JeanPatrique/ProjetButESE/emetteur/misc/imageCamera.jpg

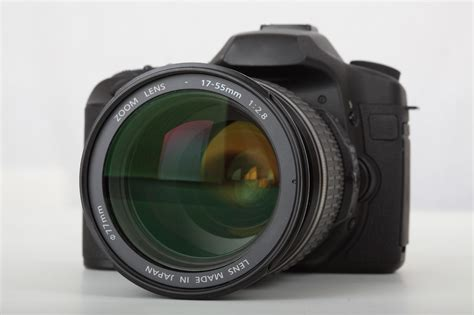
emetteur/misc/imageCamera.jpg
