JeanPatrique/ProjetButESE/emetteur/misc/imageCableVGA.jpg

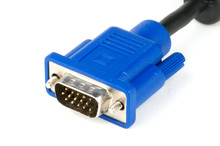
emetteur/misc/imageCableVGA.jpg
