JeanPatrique/ProjetButESE/recepteur/sub_sheets/res/chronogramme_memoryIC_ISSI.png

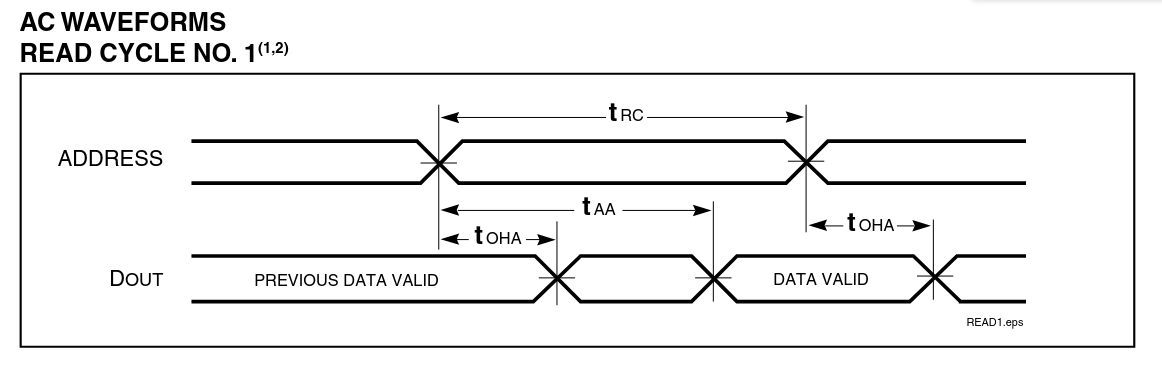
recepteur/sub_sheets/res/chronogramme_memoryIC_ISSI.png
