JeanPatrique/ProjetButESE/emetteur/symbolesEtEmpreintes/AND_1b/AND_gate_NL17SZ08DBVT1G.stp

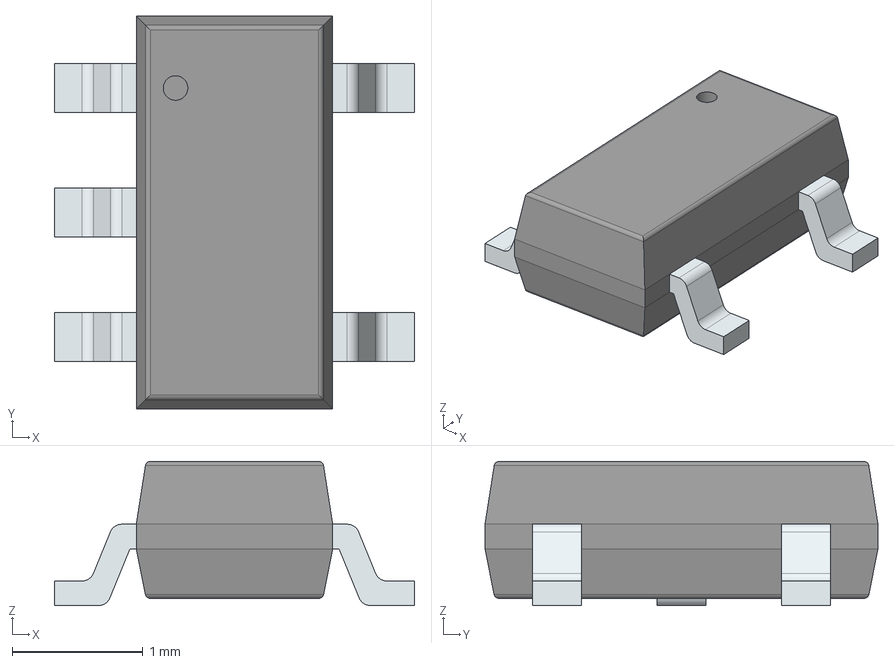
[picture p4: CAD file, 2026-03-14]
emetteur/symbolesEtEmpreintes/AND_1b/AND_gate_NL17SZ08DBVT1G.stp
2.75 x 3.00 x 1.10 mm
PinsArrayL
PinsArrayR
