JeanPatrique/ProjetButESE/emetteur/symbolesEtEmpreintes/C_100n/C_100n_C1608X7R1H104K080AA.stp

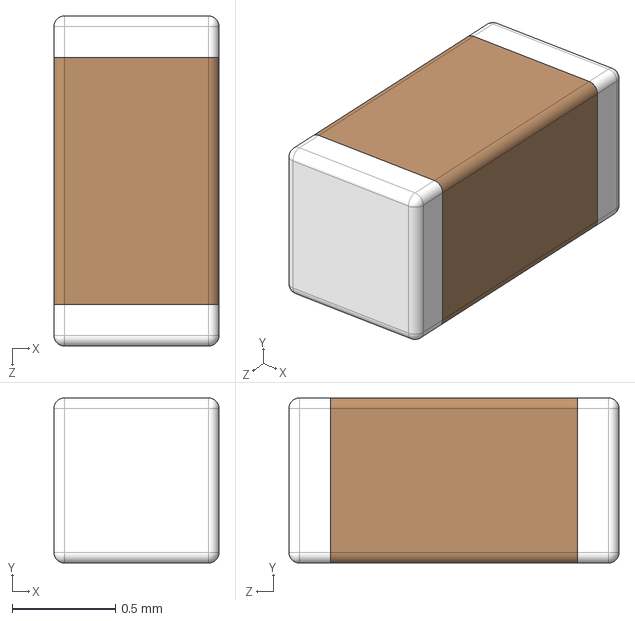
[picture p5: CAD file, 2026-03-14]
emetteur/symbolesEtEmpreintes/C_100n/C_100n_C1608X7R1H104K080AA.stp
0.8 x 0.8 x 1.60 mm
