JeanPatrique/ProjetButESE/emetteur/symbolesEtEmpreintes/C_1u/C_1u_C1005X5R1E105K050BC.stp

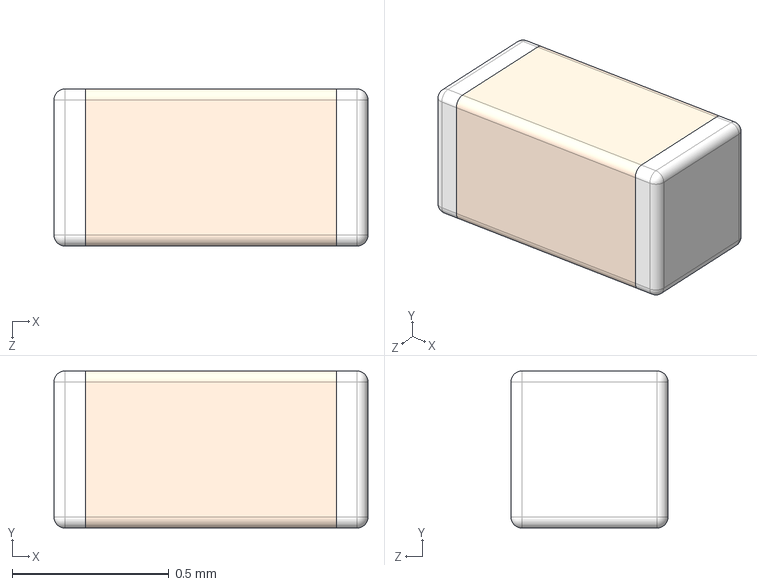
[picture p6: CAD file, 2026-03-14]
emetteur/symbolesEtEmpreintes/C_1u/C_1u_C1005X5R1E105K050BC.stp
1.00 x 0.5 x 0.5 mm
