JeanPatrique/ProjetButESE/emetteur/symbolesEtEmpreintes/C_2u2/C_2u2_C2012X7R1H225K125AE.stp

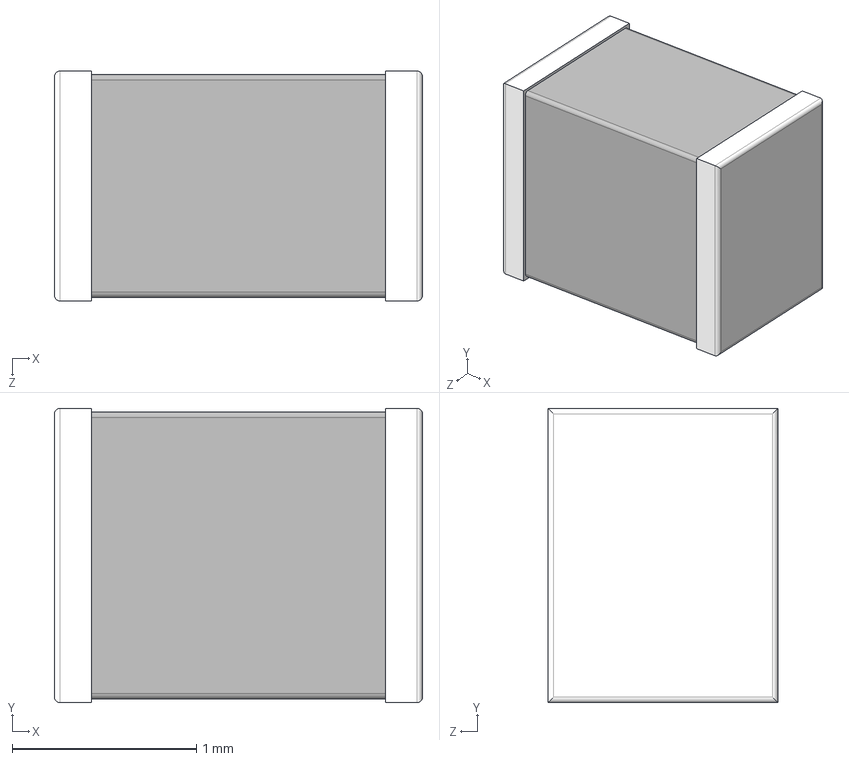
[picture p7: CAD file, 2026-03-14]
emetteur/symbolesEtEmpreintes/C_2u2/C_2u2_C2012X7R1H225K125AE.stp
2.00 x 1.60 x 1.25 mm
