JeanPatrique/ProjetButESE/emetteur/symbolesEtEmpreintes/C_47u/C_47u_C3216X5R1E476M160AC.stp

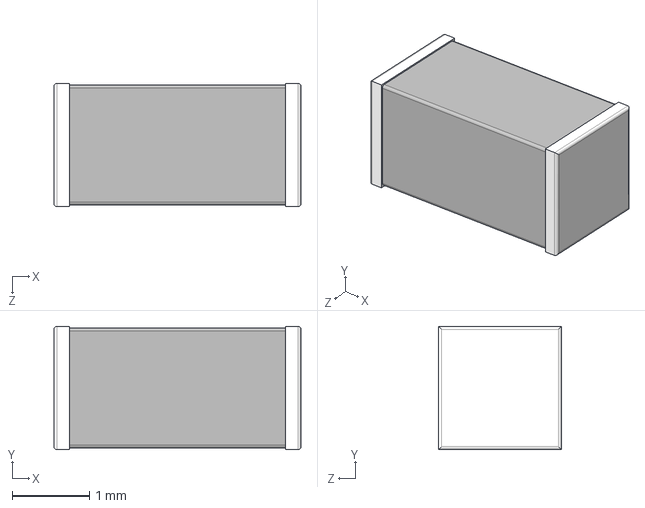
[picture p8: CAD file, 2026-03-14]
emetteur/symbolesEtEmpreintes/C_47u/C_47u_C3216X5R1E476M160AC.stp
3.20 x 1.60 x 1.60 mm
