JeanPatrique/ProjetButESE/emetteur/symbolesEtEmpreintes/counter_8b/counter_8b_SN74HCS594DYYR.stp

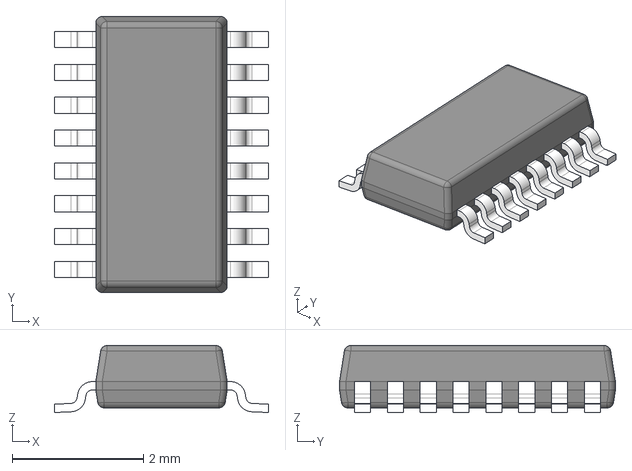
[picture p9: CAD file, 2026-03-14]
emetteur/symbolesEtEmpreintes/counter_8b/counter_8b_SN74HCS594DYYR.stp
3.26 x 4.20 x 1.02 mm
BODY-TSSOP
LEAD-TSSOP x 16
