JeanPatrique/ProjetButESE/emetteur/symbolesEtEmpreintes/D_latches_x8/D_latches_x8_74LVC373APW,118.stp

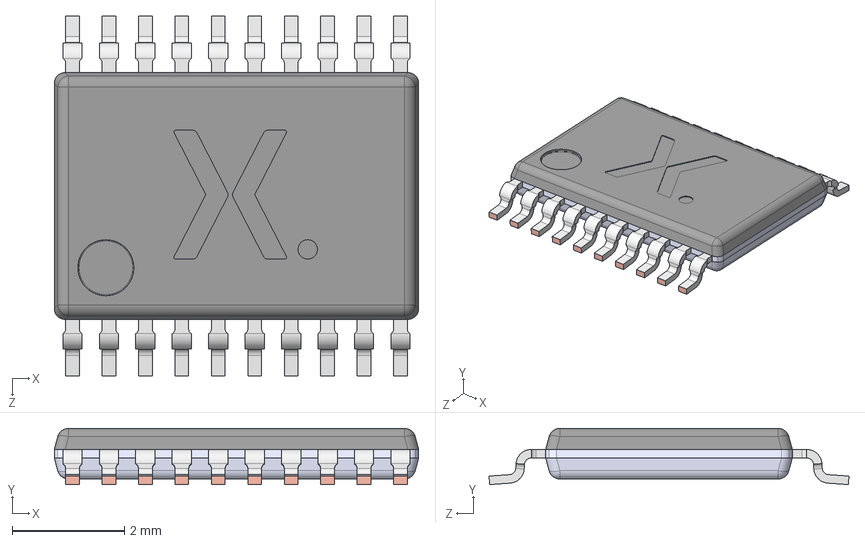
[picture p10: CAD file, 2026-03-14]
emetteur/symbolesEtEmpreintes/D_latches_x8/D_latches_x8_74LVC373APW,118.stp
6.50 x 1.00 x 6.42 mm
SOT360-1 Lower Mold body
SOT360-1 Lead
SOT360-1 Upper Mold body
