JeanPatrique/ProjetButESE/emetteur/symbolesEtEmpreintes/Diode_TVS/DF2S23P2FU,H3F.stp

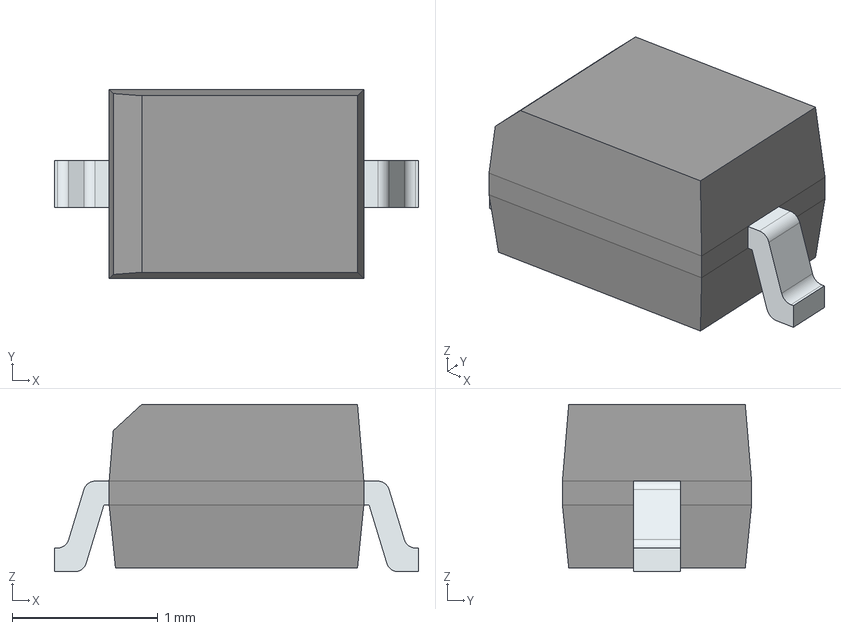
[picture p11: CAD file, 2026-03-14]
emetteur/symbolesEtEmpreintes/Diode_TVS/DF2S23P2FU,H3F.stp
2.50 x 1.30 x 1.15 mm
FilletPinL
FilletPinR
