JeanPatrique/ProjetButESE/emetteur/symbolesEtEmpreintes/JK_latch/JK_latch_SN74LVC112ADR.stp

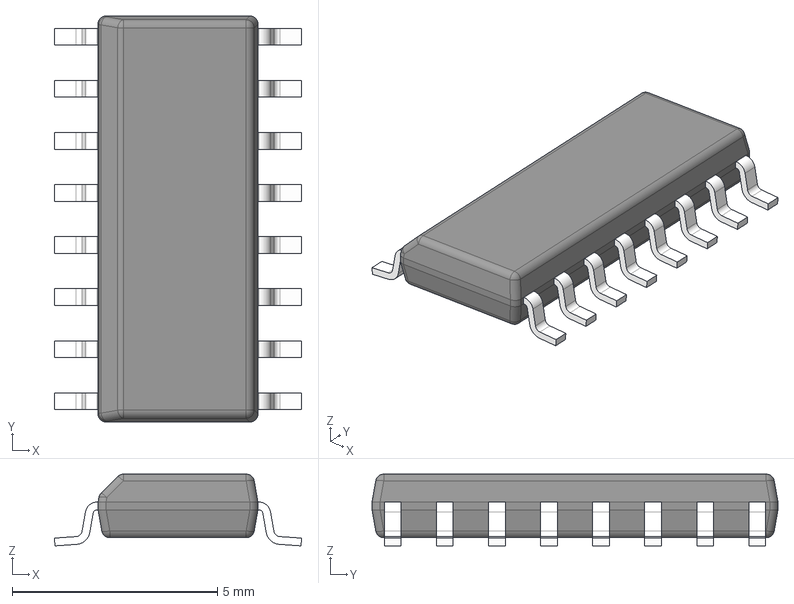
[picture p12: CAD file, 2026-03-14]
emetteur/symbolesEtEmpreintes/JK_latch/JK_latch_SN74LVC112ADR.stp
6.03 x 9.90 x 1.75 mm
BODY-SO
LEAD-SO x 16
PIN1-ID
