JeanPatrique/ProjetButESE/emetteur/symbolesEtEmpreintes/led_verte/LED_VERTE_HLMP-Y502-F0000.stp

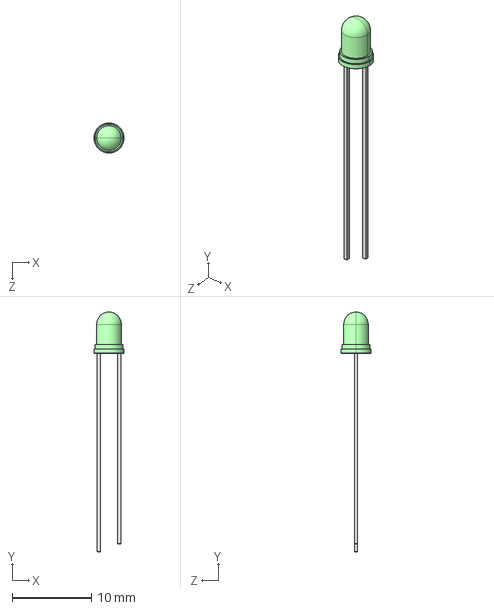
[picture p13: CAD file, 2026-03-14]
emetteur/symbolesEtEmpreintes/led_verte/LED_VERTE_HLMP-Y502-F0000.stp
3.80 x 30.2 x 3.80 mm
