JeanPatrique/ProjetButESE/emetteur/symbolesEtEmpreintes/mcu/MCU_STM32H523CET6.stp

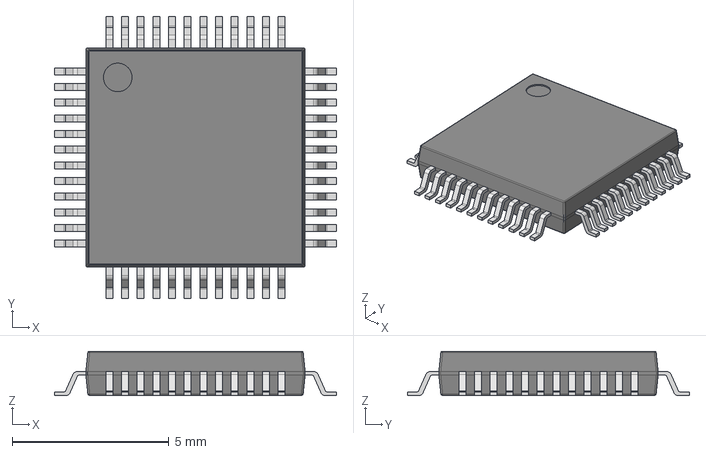
[picture p14: CAD file, 2026-03-14]
emetteur/symbolesEtEmpreintes/mcu/MCU_STM32H523CET6.stp
9.00 x 9.00 x 1.41 mm
