JeanPatrique/ProjetButESE/emetteur/symbolesEtEmpreintes/NAND_1b/NAND_gate_NC7SZ00M5X.stp

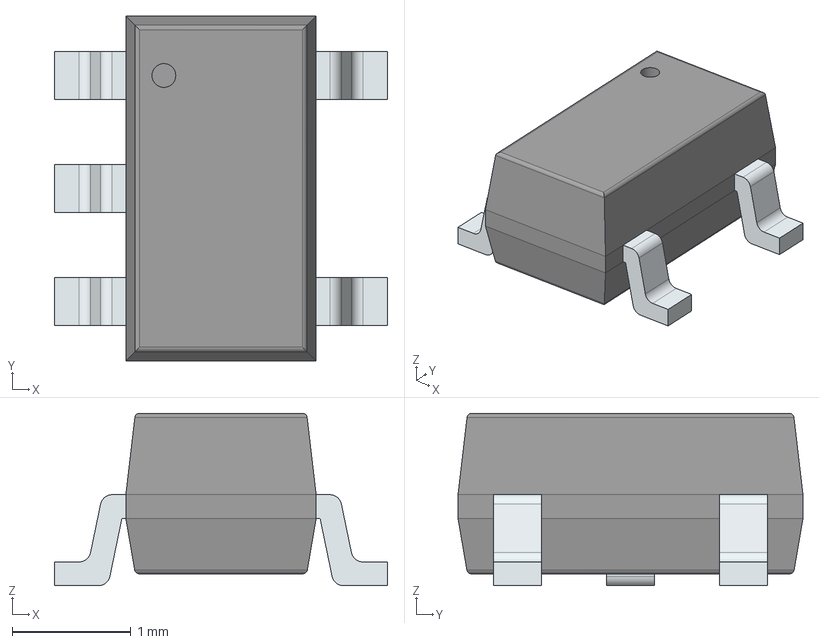
[picture p15: CAD file, 2026-03-14]
emetteur/symbolesEtEmpreintes/NAND_1b/NAND_gate_NC7SZ00M5X.stp
2.80 x 2.90 x 1.45 mm
PinsArrayL
PinsArrayR
