JeanPatrique/ProjetButESE/emetteur/symbolesEtEmpreintes/OR_1b/OR_gate_NL17SZ32XV5T2G.stp

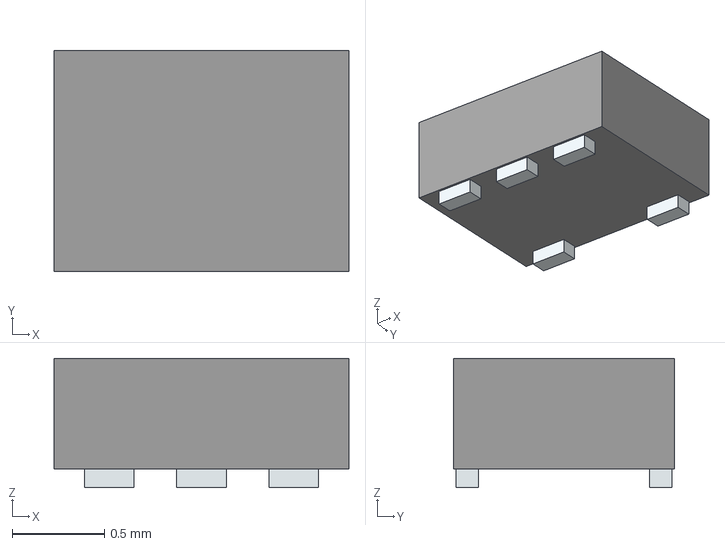
[picture p16: CAD file, 2026-03-14]
emetteur/symbolesEtEmpreintes/OR_1b/OR_gate_NL17SZ32XV5T2G.stp
1.60 x 1.20 x 0.7 mm
Pins
