JeanPatrique/ProjetButESE/emetteur/symbolesEtEmpreintes/plexeur_1b/plexeur_1b_74LVC1G3157GW,125.stp

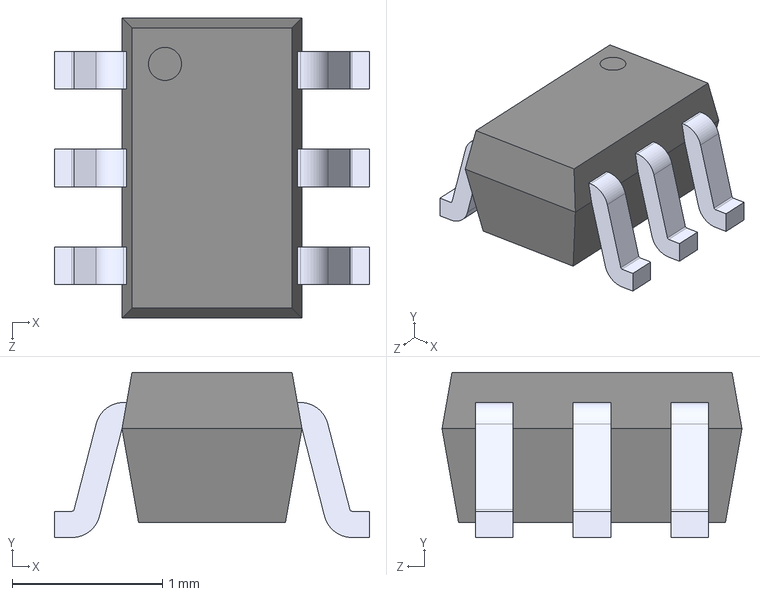
[picture p17: CAD file, 2026-03-14]
emetteur/symbolesEtEmpreintes/plexeur_1b/plexeur_1b_74LVC1G3157GW,125.stp
2.10 x 1.10 x 2.00 mm
