JeanPatrique/ProjetButESE/emetteur/symbolesEtEmpreintes/powerJackConnector/PowerJackCon_PJ-114AH-SMT-TR.stp

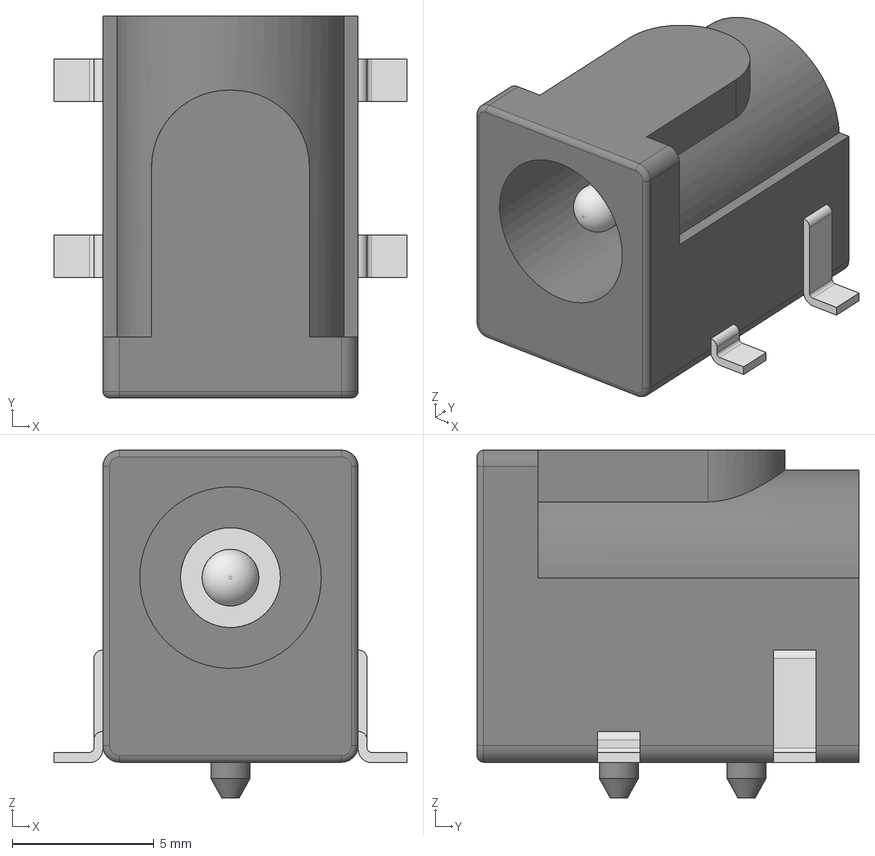
[picture p18: CAD file, 2026-03-14]
emetteur/symbolesEtEmpreintes/powerJackConnector/PowerJackCon_PJ-114AH-SMT-TR.stp
12.4 x 13.5 x 12.3 mm
