JeanPatrique/ProjetButESE/emetteur/symbolesEtEmpreintes/regulateur_3v3_1A/regulateur_3V3_1A_TLV76133DCYR.stp

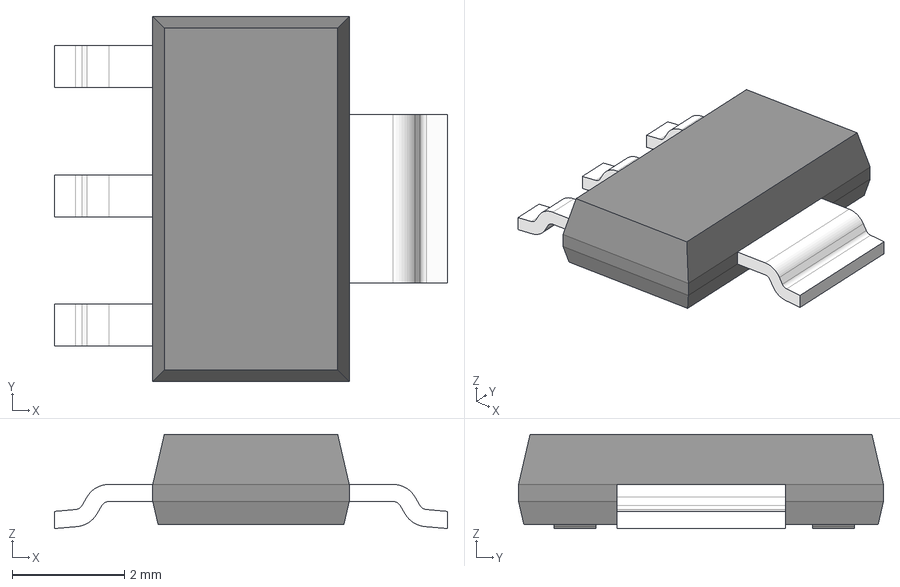
[picture p19: CAD file, 2026-03-14]
emetteur/symbolesEtEmpreintes/regulateur_3v3_1A/regulateur_3V3_1A_TLV76133DCYR.stp
7.00 x 6.50 x 1.68 mm
BODY-SOT
LEAD-SOT x 3
LEAD-SOT-WIDE
PIN1-ID
