JeanPatrique/ProjetButESE/emetteur/symbolesEtEmpreintes/SRAM/SRAM_IS61WV5128FBLL-10TLI.stp

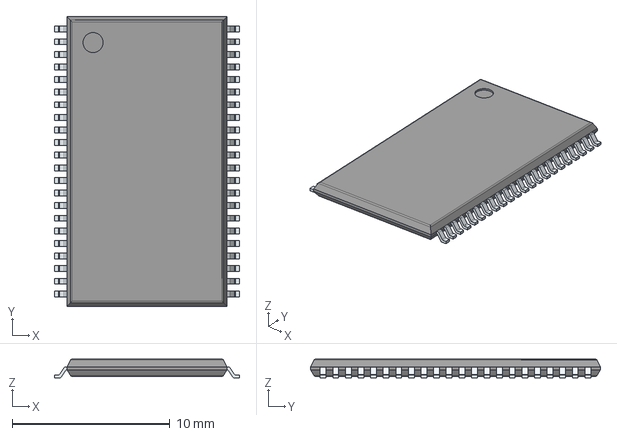
[picture p20: CAD file, 2026-03-14]
emetteur/symbolesEtEmpreintes/SRAM/SRAM_IS61WV5128FBLL-10TLI.stp
11.8 x 18.4 x 1.20 mm
PinsArrayLR
