JeanPatrique/ProjetButESE/emetteur/symbolesEtEmpreintes/switch_3/swicth_3_DS01C-254-L-03BE.stp

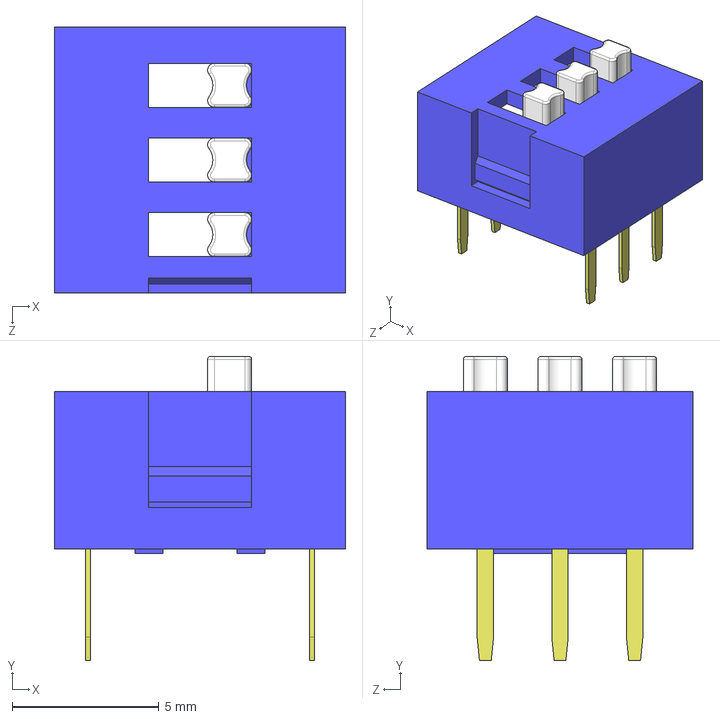
[picture p21: CAD file, 2026-03-14]
emetteur/symbolesEtEmpreintes/switch_3/swicth_3_DS01C-254-L-03BE.stp
9.90 x 10.4 x 9.04 mm
