JeanPatrique/ProjetButESE/emetteur/symbolesEtEmpreintes/led_verte/LED_ROUGE_HLMP-Y301-F0000.stp

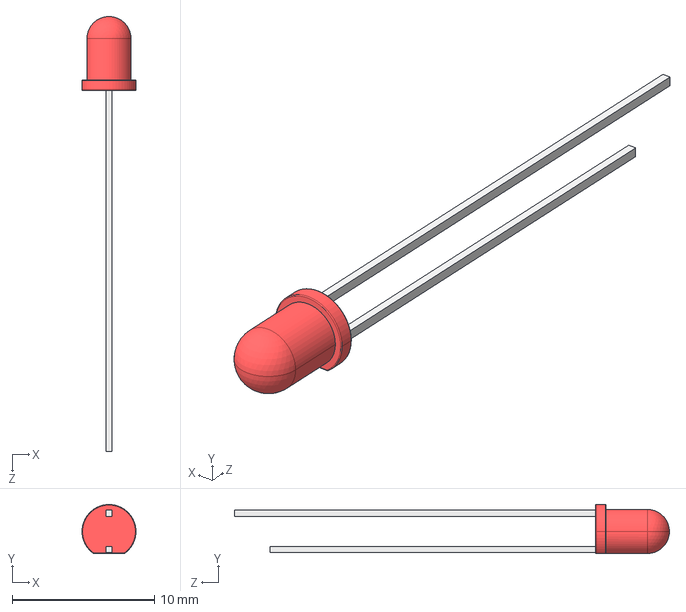
[picture p22: CAD file, 2026-03-14]
emetteur/symbolesEtEmpreintes/led_verte/LED_ROUGE_HLMP-Y301-F0000.stp
3.80 x 3.45 x 30.6 mm
