JeanPatrique/ProjetButESE/emetteur/schemasEmetteur_rev1.pdf

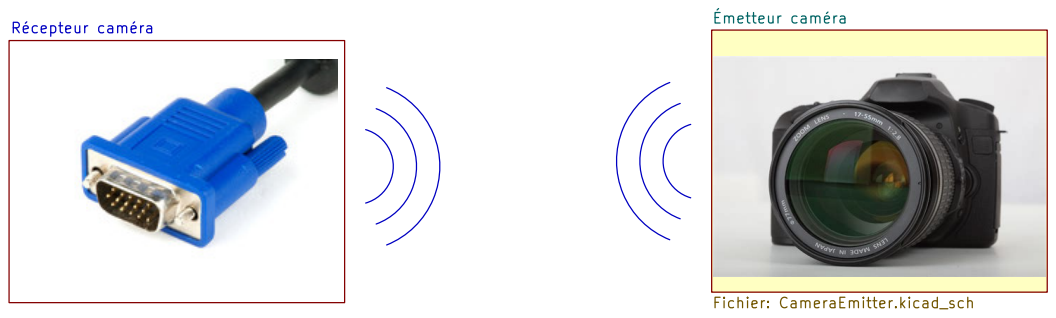
[picture p23: page 1]

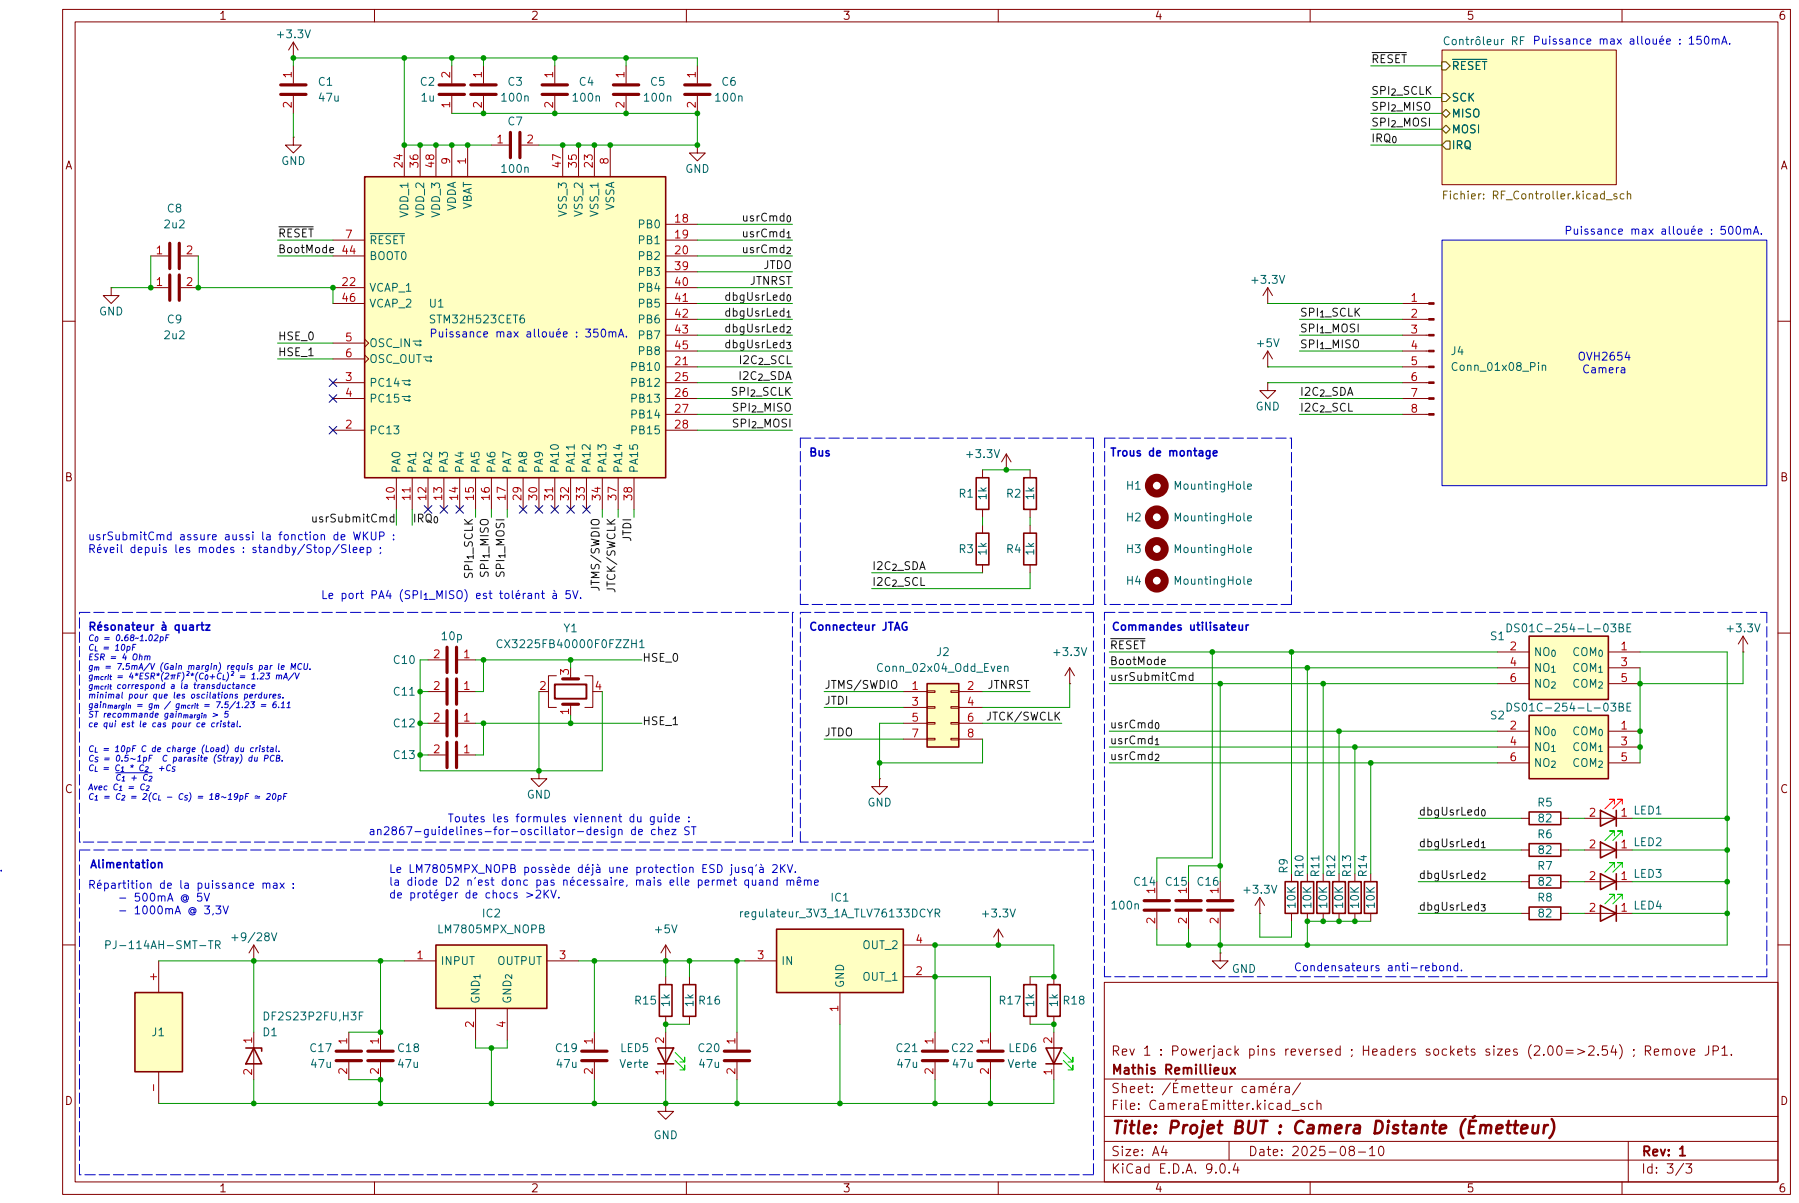
[picture p24: page 2]

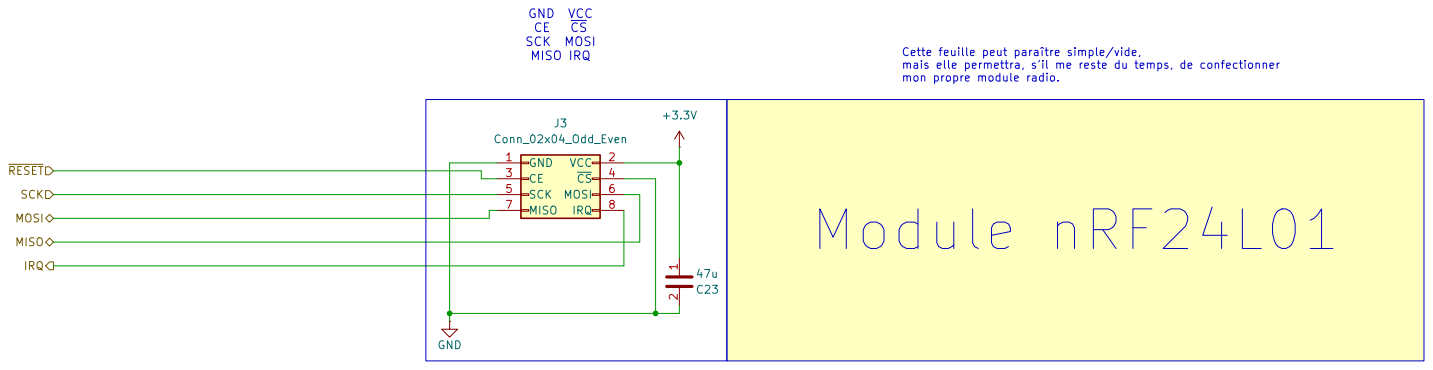
[picture p25: page 3]
