JeanPatrique/ProjetButESE/emetteur/schemasEmetteur_rev0.pdf

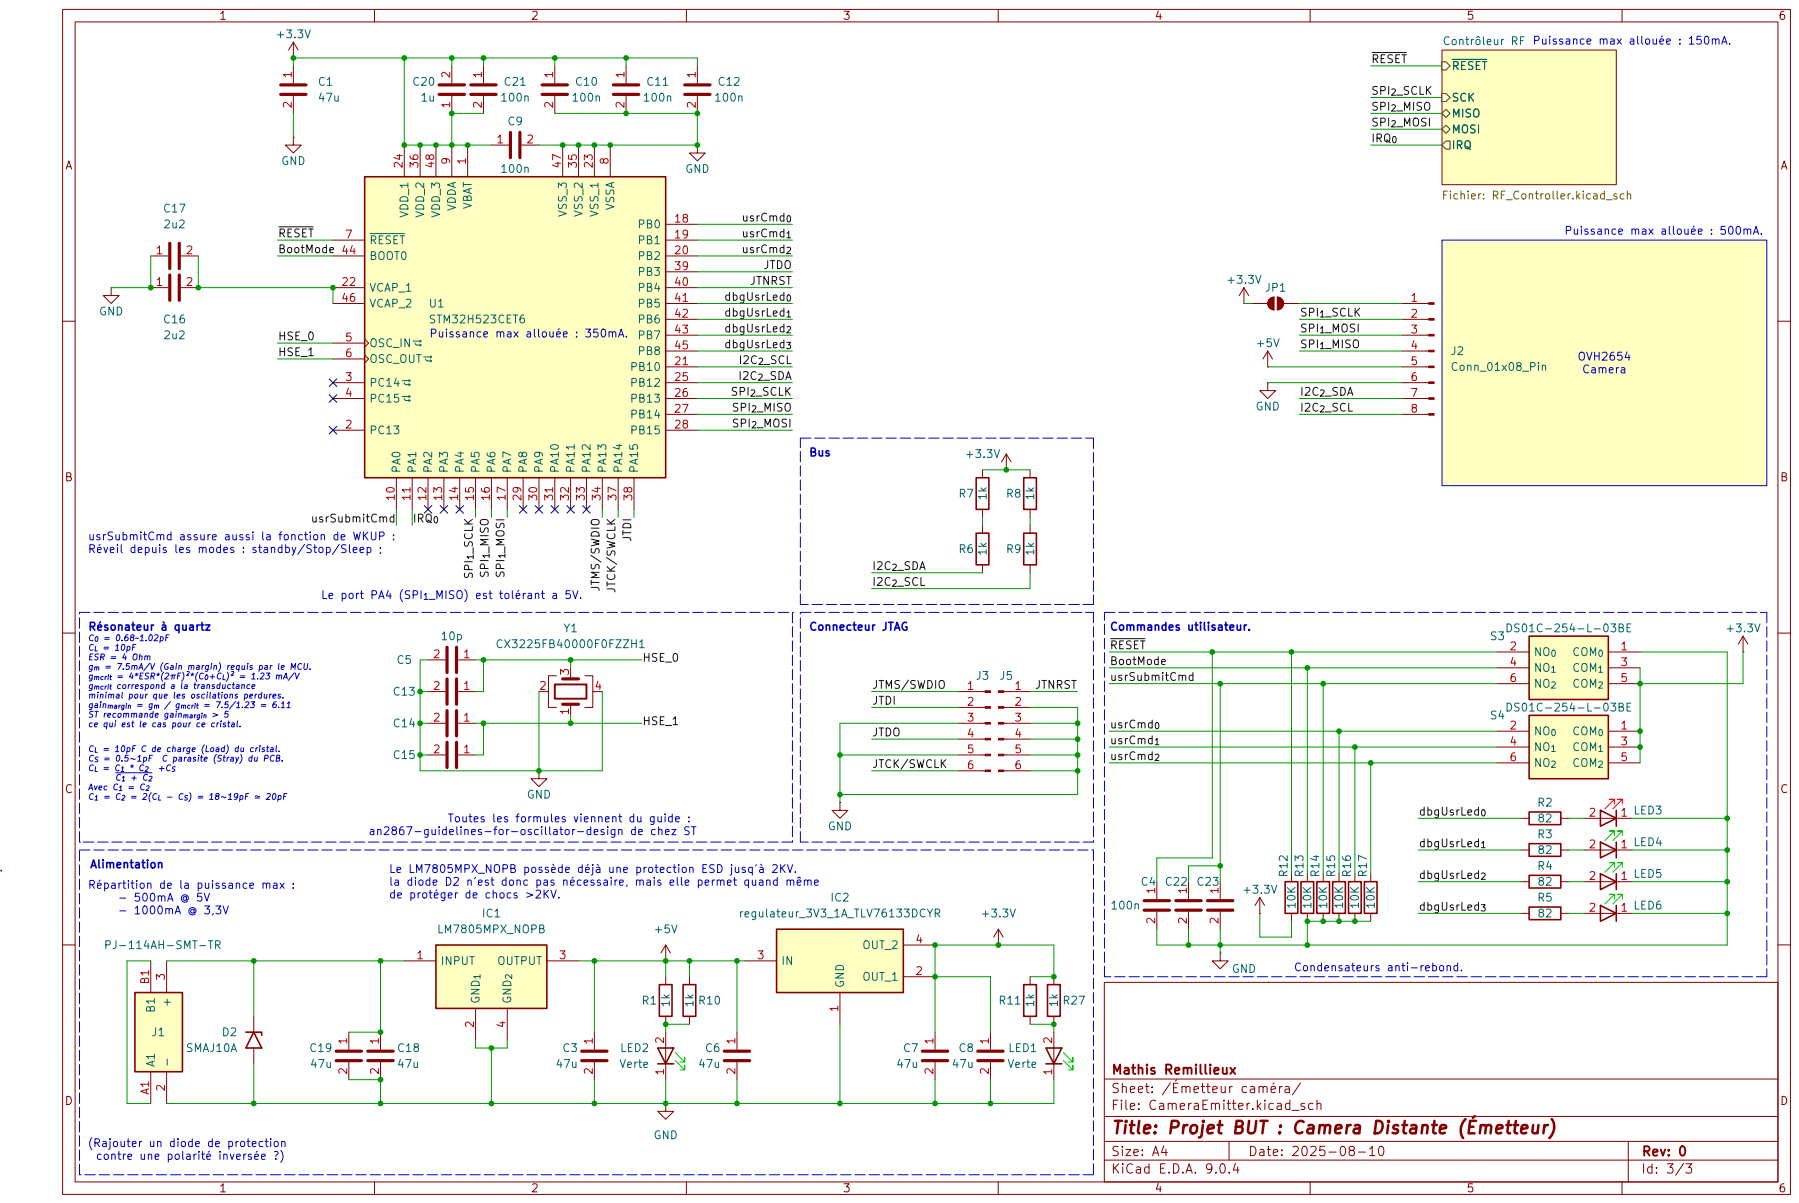
[picture p26: page 2]

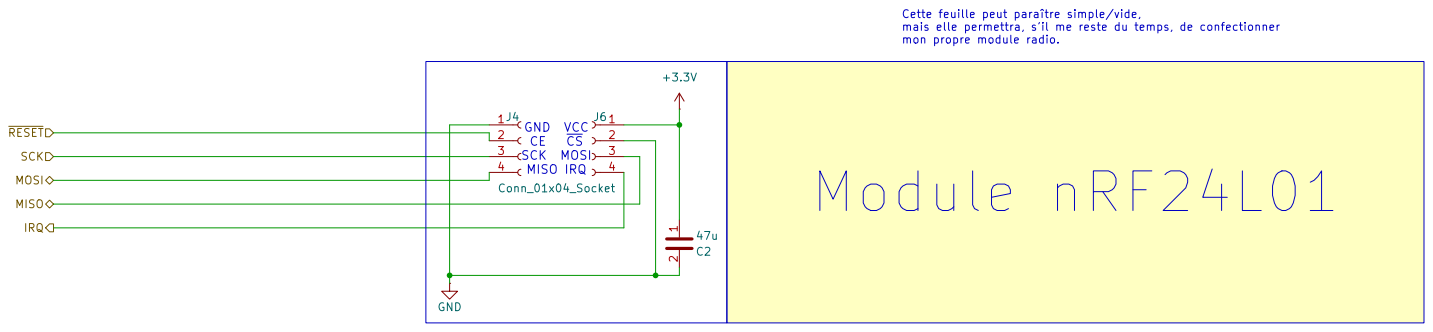
[picture p27: page 3]
