JeanPatrique/ProjetButESE/Cartes de tests et prototypes/carte de test du convertisseur numerique vers analogique/testCNA.kicad_pcb

## KiCad design Cartes de tests et prototypes/carte de test du convertisseur numerique vers analogique/testCNA.kicad_pcb (2026-03-14)

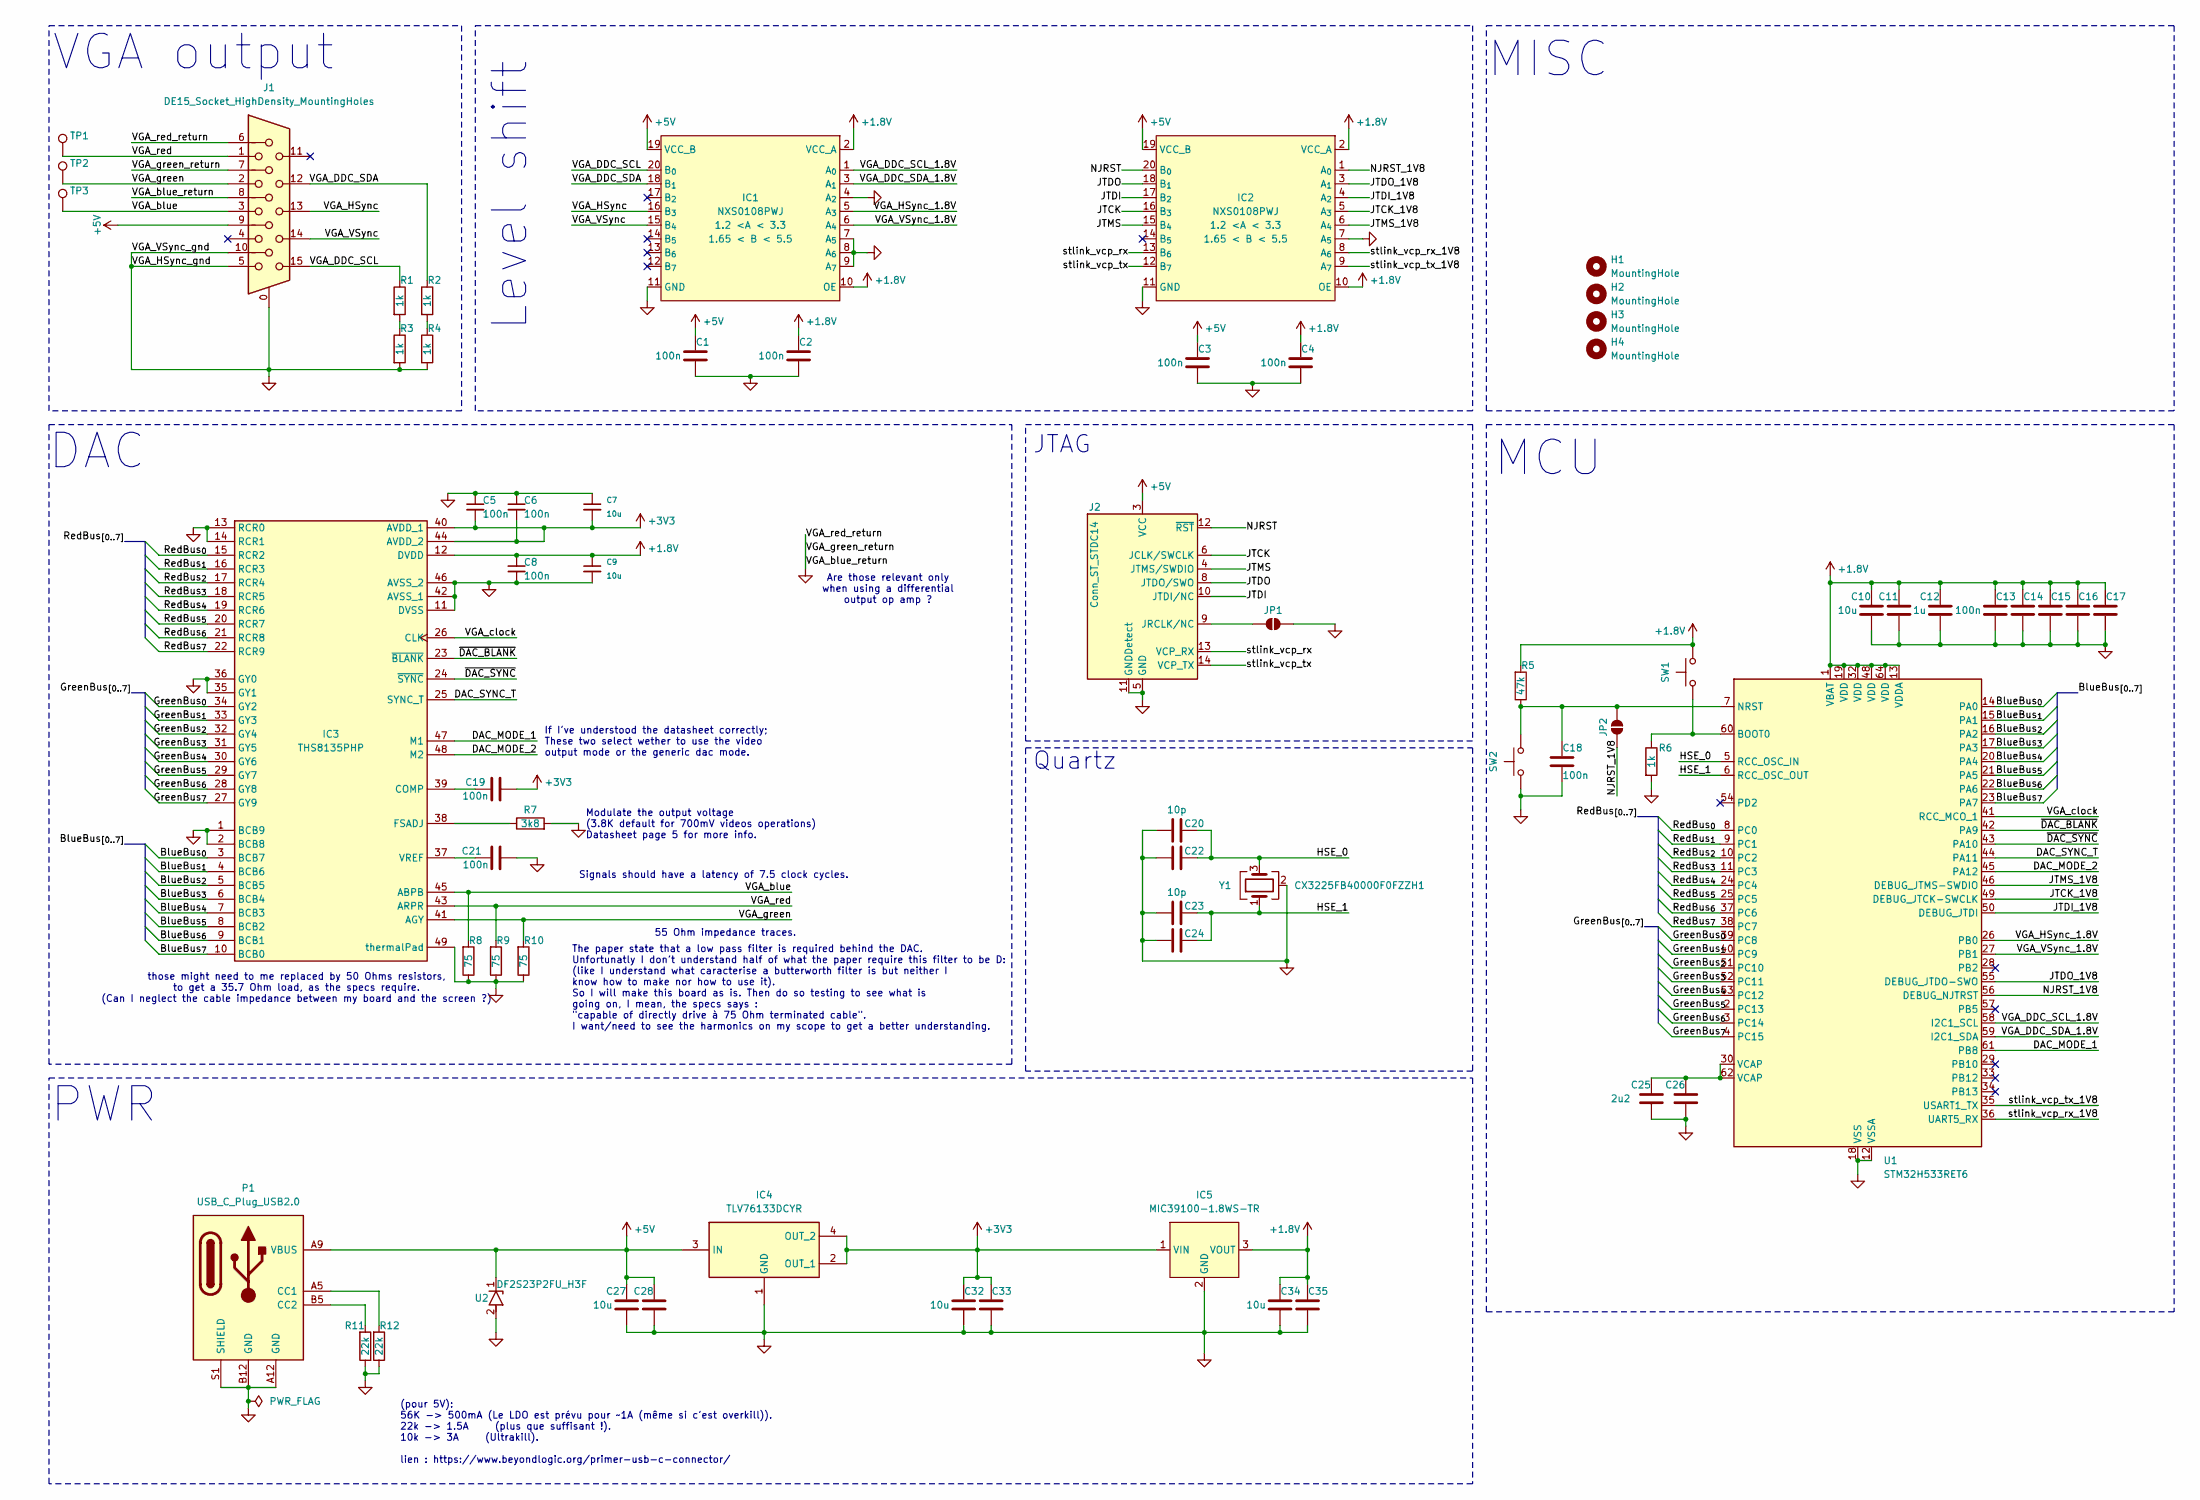
[picture p28: schematic testCNA.kicad_sch, Carte video simpliste]

Parts:
C1, C2, C3, C4, C5, C6, C8, C13, C14, C15, C16, C17, C18, C19, C21: 100n; C_0805_2012Metric_Pad1.18x1.45mm_HandSolder; Mouser Part Number 581-08055C104ZAT2A
C7, C9, C10, C11, C27, C28, C32, C33, C34, C35: 10u; C_1206_3216Metric_Pad1.33x1.80mm_HandSolder; Mouser Part Number 603-CC126ZKY5V7BB106
C12: 1u; C_1206_3216Metric_Pad1.33x1.80mm_HandSolder; Mouser Part Number 810-C3216X7R1H105K
C20, C22, C23, C24: 10p; C_1206_3216Metric_Pad1.33x1.80mm_HandSolder; Mouser Part Number 80-C1206C100J5GACTU
C25, C26: 2u2; C_1206_3216Metric_Pad1.33x1.80mm_HandSolder; Mouser Part Number 603-CC126KKX7R6BB225
H1, H2, H3, H4: MountingHole; MountingHole_3.2mm_M3
IC1, IC2: NXS0108PWJ; TSSOP-20_4.4x6.5mm_P0.65mm; Mouser Part Number 771-NXS0108PWJ
IC3: THS8135PHP; Texas_PHP0048E_HTQFP-48-1EP_7x7mm_P0.5mm_EP6.5x6.5mm_Mask3.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; Mouser Part Number 595-THS8135PHP
IC4: TLV76133DCYR; SOT-223; Mouser Part Number 595-TLV76133DCYR
IC5: MIC39100-1.8WS-TR; SOT-223-3_TabPin2; Mouser Part Number 998-MIC39100-1.8WSTR
J1: DE15_Socket_HighDensity_MountingHoles; DSUB-15_Socket_Horizontal_P2.77x2.84mm_EdgePinOffset7.70mm_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
J2: Conn_ST_STDC14; PinHeader_2x07_P1.27mm_Vertical_SMD
JP1, JP2: SolderJumper_2_Open; SolderJumper-2_P1.3mm_Open_RoundedPad1.0x1.5mm
P1: USB_C_Plug_USB2.0; USB_C_Receptacle_GCT_USB4125-xx-x-0190_6P_TopMnt_Horizontal; Mouser Part Number 179-UJCHGSMT2P6TR
R1, R2, R3, R4, R6: 1k; R_1206_3216Metric_Pad1.30x1.75mm_HandSolder; Mouser Part Number 603-RT1206DRD071KL
R5: 47k; R_1206_3216Metric_Pad1.30x1.75mm_HandSolder; Mouser Part Number 603-RT1206FRD0747KL
R7: 3k8; R_1206_3216Metric_Pad1.30x1.75mm_HandSolder; Mouser Part Number 603-RT1206BRD073K83L
R8, R9, R10: 75; R_1206_3216Metric_Pad1.30x1.75mm_HandSolder; Mouser Part Number 667-ERA-8AEB750V
R11, R12: 22k; R_1206_3216Metric_Pad1.30x1.75mm_HandSolder; Mouser Part Number 603-RT1206FRD0722KL
SW1, SW2: TS02-66-100-BK-100-SCR-D; SW_PUSH_6mm_H4.3mm; Mouser Part Number 179-TS0266100BK100SC
TP1, TP2, TP3: TestPoint; TestPoint_THTPad_D2.0mm_Drill1.0mm
U1: STM32H533RET6; LQFP-64_10x10mm_P0.5mm; Mouser Part Number 511-STM32H533RET6
U2: DF2S23P2FU_H3F; D_SOD-323_HandSoldering; Mouser Part Number 757-DF2S23P2FUH3F
Y1: CX3225FB40000F0FZZH1; Crystal_SMD_3225-4Pin_3.2x2.5mm_HandSoldering; Mouser Part Number 581-CX3225FB40F0FZZH

Connections:
+1.8V: C2.1, C4.1, C8.1, C9.1, C10.1, C11.1, C12.1, C13.1, C14.1, C15.1, C16.1, C17.1, C34.1, C35.1, IC1.2 (VCC_A), IC1.10 (OE), IC2.2 (VCC_A), IC2.10 (OE), IC3.12 (DVDD), IC5.3 (VOUT), R5.1, SW1.2, U1.1 (VBAT), U1.13 (VDDA), U1.19 (VDD), U1.32 (VDD), U1.48 (VDD), U1.64 (VDD)
+3V3: C5.2, C6.2, C7.2, C19.2, C32.1, C33.1, IC3.40 (AVDD_1), IC3.44 (AVDD_2), IC4.2 (OUT_1), IC4.4 (OUT_2), IC5.1 (VIN)
+5V: C1.1, C3.1, C27.1, C28.1, IC1.19 (VCC_B), IC2.19 (VCC_B), IC4.3 (IN), J1.9, J2.3 (VCC), P1.A9 (VBUS), P1.B9 (VBUS), U2.1
/BlueBus_{0}: IC3.3 (BCB7), U1.14 (PA0)
/BlueBus_{1}: IC3.4 (BCB6), U1.15 (PA1)
/BlueBus_{2}: IC3.5 (BCB5), U1.16 (PA2)
/BlueBus_{3}: IC3.6 (BCB4), U1.17 (PA3)
/BlueBus_{4}: IC3.7 (BCB3), U1.20 (PA4)
/BlueBus_{5}: IC3.8 (BCB2), U1.21 (PA5)
/BlueBus_{6}: IC3.9 (BCB1), U1.22 (PA6)
/BlueBus_{7}: IC3.10 (BCB0), U1.23 (PA7)
/DAC_MODE_1: IC3.47 (M1), U1.61 (PB8)
/DAC_MODE_2: IC3.48 (M2), U1.45 (PA12)
/DAC_SYNC_T: IC3.25 (SYNC_T), U1.44 (PA11)
/GreenBus_{0}: IC3.34 (GY2), U1.39 (PC8)
/GreenBus_{1}: IC3.33 (GY3), U1.40 (PC9)
/GreenBus_{2}: IC3.32 (GY4), U1.51 (PC10)
/GreenBus_{3}: IC3.31 (GY5), U1.52 (PC11)
/GreenBus_{4}: IC3.30 (GY6), U1.53 (PC12)
/GreenBus_{5}: IC3.29 (GY7), U1.2 (PC13)
/GreenBus_{6}: IC3.28 (GY8), U1.3 (PC14)
/GreenBus_{7}: IC3.27 (GY9), U1.4 (PC15)
/HSE_0: C20.2, C22.2, U1.5 (RCC_OSC_IN), Y1.3
/HSE_1: C23.2, C24.2, U1.6 (RCC_OSC_OUT), Y1.1
/JTCK: IC2.16 (B_{3}), J2.6 (JCLK/SWCLK)
/JTCK_1V8: IC2.5 (A_{3}), U1.49 (DEBUG_JTCK-SWCLK)
/JTDI: IC2.17 (B_{2}), J2.10 (JTDI/NC)
/JTDI_1V8: IC2.4 (A_{2}), U1.50 (DEBUG_JTDI)
/JTDO: IC2.18 (B_{1}), J2.8 (JTDO/SWO)
/JTDO_1V8: IC2.3 (A_{1}), U1.55 (DEBUG_JTDO-SWO)
/JTMS: IC2.15 (B_{4}), J2.4 (JTMS/SWDIO)
/JTMS_1V8: IC2.6 (A_{4}), U1.46 (DEBUG_JTMS-SWDIO)
/NJRST: IC2.20 (B_{0}), J2.12 (~RST)
/NJRST_1V8: IC2.1 (A_{0}), JP2.1 (A), U1.56 (DEBUG_NJTRST)
/RedBus_{0}: IC3.15 (RCR2), U1.8 (PC0)
/RedBus_{1}: IC3.16 (RCR3), U1.9 (PC1)
/RedBus_{2}: IC3.17 (RCR4), U1.10 (PC2)
/RedBus_{3}: IC3.18 (RCR5), U1.11 (PC3)
/RedBus_{4}: IC3.19 (RCR6), U1.24 (PC4)
/RedBus_{5}: IC3.20 (RCR7), U1.25 (PC5)
/RedBus_{6}: IC3.21 (RCR8), U1.37 (PC6)
/RedBus_{7}: IC3.22 (RCR9), U1.38 (PC7)
/VGA_DDC_SCL: IC1.20 (B_{0}), J1.15, R1.1
/VGA_DDC_SCL_1.8V: IC1.1 (A_{0}), U1.58 (I2C1_SCL)
/VGA_DDC_SDA: IC1.18 (B_{1}), J1.12, R2.1
/VGA_DDC_SDA_1.8V: IC1.3 (A_{1}), U1.59 (I2C1_SDA)
/VGA_HSync: IC1.16 (B_{3}), J1.13
/VGA_HSync_1.8V: IC1.5 (A_{3}), U1.26 (PB0)
/VGA_VSync: IC1.15 (B_{4}), J1.14
/VGA_VSync_1.8V: IC1.6 (A_{4}), U1.27 (PB1)
/VGA_blue: IC3.45 (ABPB), J1.3, R8.1, TP3.1
/VGA_clock: IC3.26 (CLK), U1.41 (RCC_MCO_1)
/VGA_green: IC3.41 (AGY), J1.2, R10.1, TP2.1
/VGA_red: IC3.43 (ARPR), J1.1, R9.1, TP1.1
/stlink_vcp_rx: IC2.13 (B_{6}), J2.13 (VCP_RX)
/stlink_vcp_rx_1V8: IC2.8 (A_{6}), U1.36 (UART5_RX)
/stlink_vcp_tx: IC2.12 (B_{7}), J2.14 (VCP_TX)
/stlink_vcp_tx_1V8: IC2.9 (A_{7}), U1.35 (USART1_TX)
/~DAC_BLANK: IC3.23 (~BLANK), U1.42 (PA9)
/~DAC_SYNC: IC3.24 (~SYNC), U1.43 (PA10)
GND: C1.2, C2.2, C3.2, C4.2, C5.1, C6.1, C7.1, C8.2, C9.2, C10.2, C11.2, C12.2, C13.2, C14.2, C15.2, C16.2, C17.2, C18.2, C20.1, C21.2, C22.1, C23.1, C24.1, C25.2, C26.2, C27.2, C28.2, C32.2, C33.2, C34.2, C35.2, IC1.4 (A_{2}), IC1.7 (A_{5}), IC1.8 (A_{6}), IC1.9 (A_{7}), IC1.11 (GND), IC2.7 (A_{5}), IC2.11 (GND), IC3.1 (BCB9), IC3.2 (BCB8), IC3.11 (DVSS), IC3.13 (RCR0), IC3.14 (RCR1), IC3.35 (GY1), IC3.36 (GY0), IC3.42 (AVSS_1), IC3.46 (AVSS_2), IC3.49 (thermalPad), IC4.1 (GND), IC5.2 (GND), J1.0, J1.5, J1.6, J1.7, J1.8, J1.10, J2.5 (GND), J2.7 (GND), J2.11 (GNDDetect), JP1.2 (B), P1.A12 (GND), P1.B12 (GND), P1.S1 (SHIELD), R3.2, R4.2, R6.2, R7.2, R8.2, R9.2, R10.2, R11.2, R12.2, SW2.1, U1.12 (VSSA), U1.18 (VSS), U1.31 (VSS), U1.47 (VSS), U1.63 (VSS), U2.2, Y1.2 (G), Y1.4 (G)
unnamed: C25.1, C26.1, U1.30 (VCAP), U1.62 (VCAP)
unnamed: C19.1, IC3.39 (COMP)
unnamed: IC3.38 (FSADJ), R7.1
unnamed: C21.1, IC3.37 (VREF)
unnamed: J2.9 (JRCLK/NC), JP1.1 (A)
unnamed: C18.1, JP2.2 (B), R5.2, SW2.2, U1.7 (NRST)
unnamed: P1.A5 (CC1), R12.1
unnamed: P1.B5 (CC2), R11.1
unnamed: R1.2, R3.1
unnamed: R2.2, R4.1
unnamed: R6.1, SW1.1, U1.60 (BOOT0)

Notes on the sheet:
The paper state that a low pass filter is required behind the DAC. Unfortunatly I don't understand half of what the paper require this filter to be D: (like I understand what caracterise a butterworth filter is but neither I know how to make nor how to use it). So I will make this board as is. Then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
(pour 5V): 56K -> 500mA (Le LDO est prévu pour ~1A (même si c'est overkill)). 22k -> 1.5A (plus que suffisant !). 10k -> 3A (Ultrakill). lien : https://www.beyondlogic.org/primer-usb-c-connector/
If I've understood the datasheet correctly; These two select wether to use the video output mode or the generic dac mode.
MCU
VGA output
PWR
JTAG
those might need to me replaced by 50 Ohms resistors, to get a 35.7 Ohm load, as the specs require. (Can I neglect the cable impedance between my board and the screen ?)
Are those relevant only when using a differential output op amp ?
Quartz
Modulate the output voltage (3.8K default for 700mV videos operations) Datasheet page 5 for more info.
MISC
Level shift
DAC
55 Ohm impedance traces.
Signals should have a latency of 7.5 clock cycles.

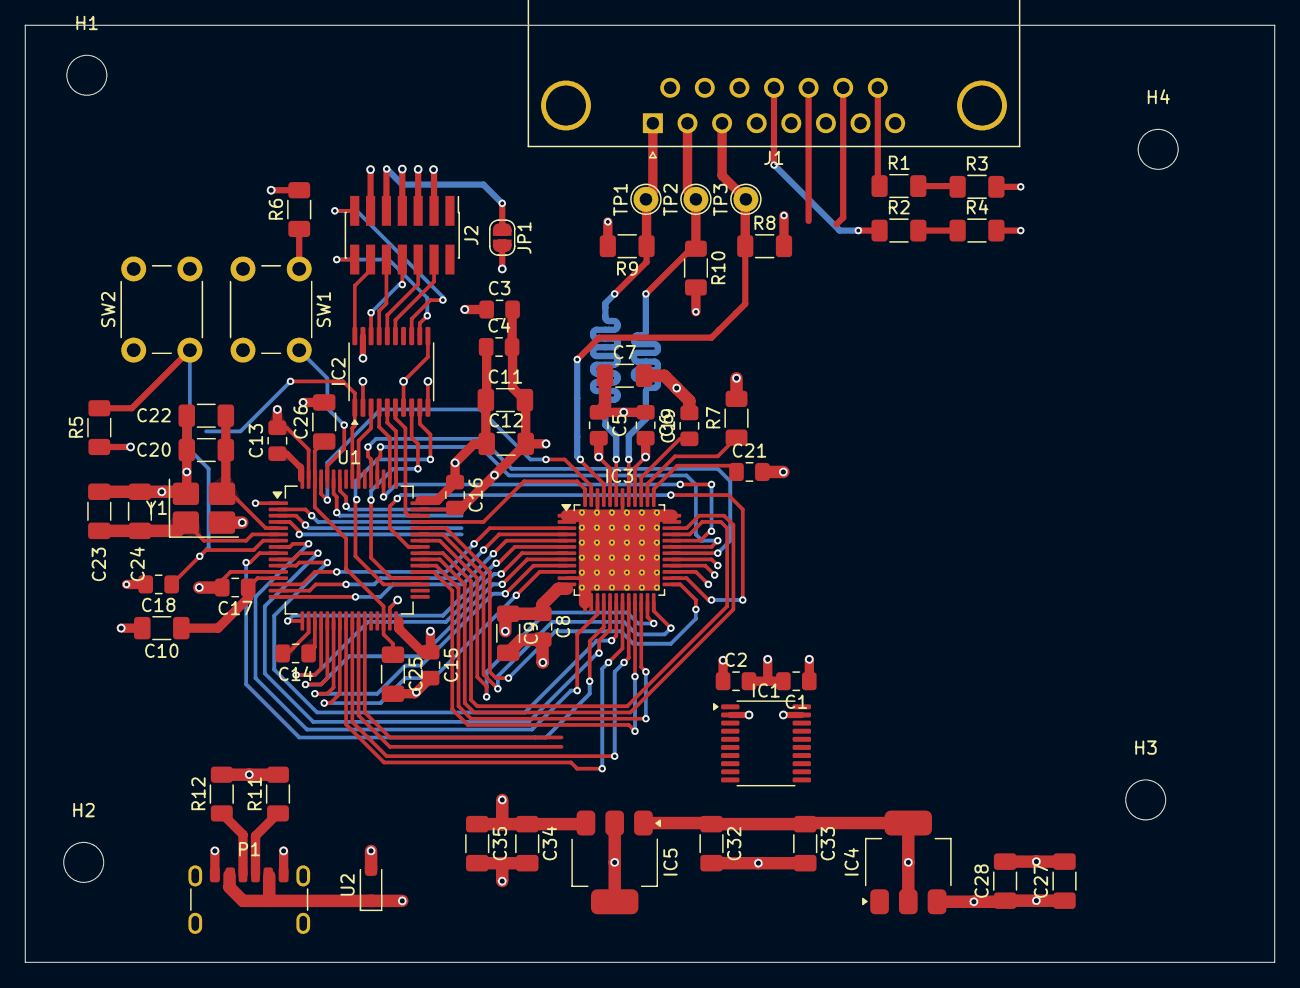
[picture p29: board testCNA.kicad_pcb from above]

Board: 4 copper layers, 100.0 x 75.0 mm, 66 parts (1 on the bottom side), 72 nets.
