JeanPatrique/ProjetButESE/emetteur/emetteur.kicad_pcb

## KiCad design emetteur/emetteur.kicad_pcb (2026-03-14)

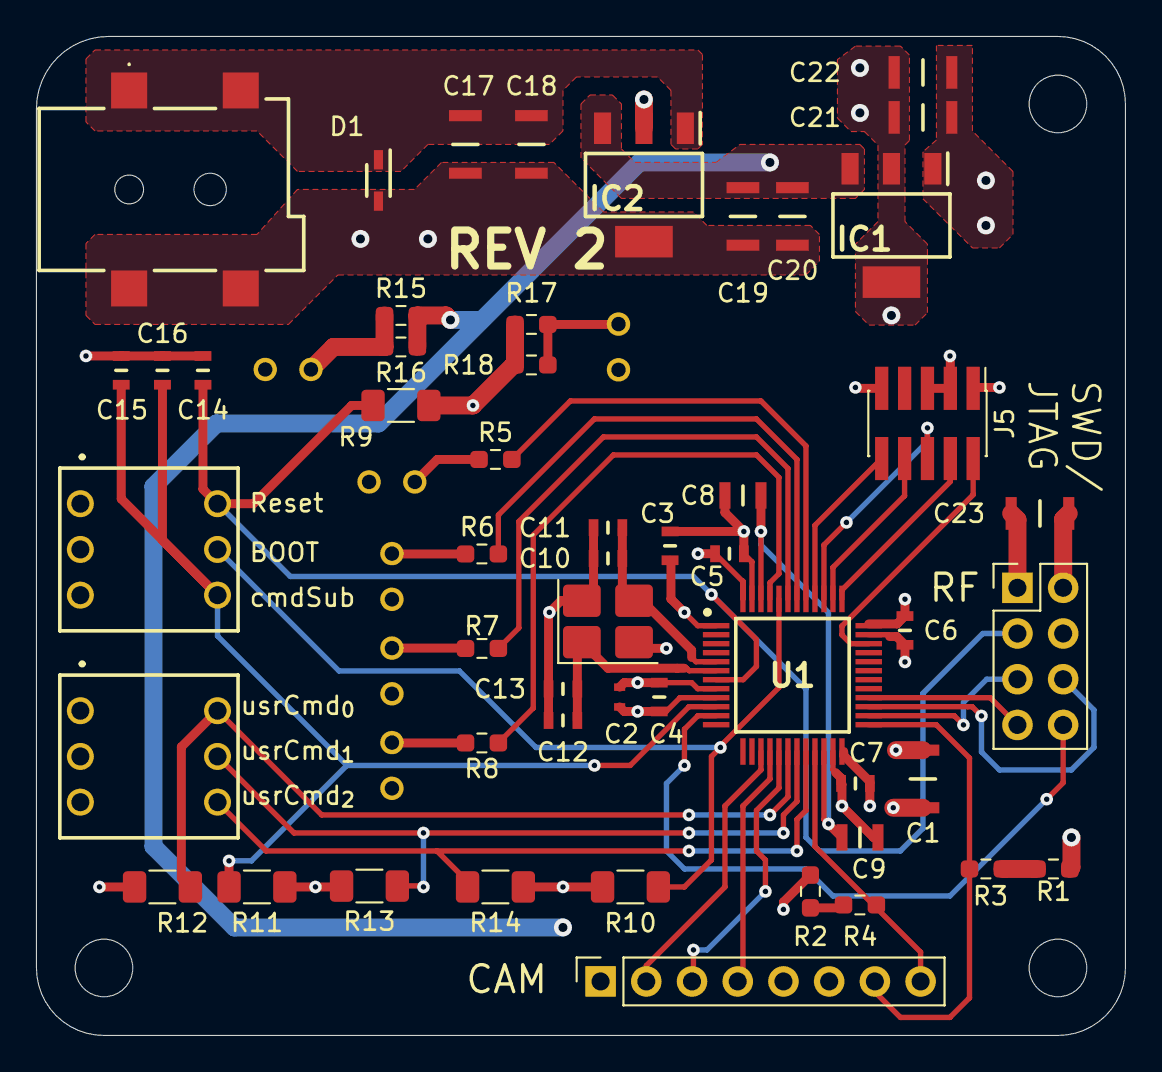
[picture p30: board emetteur.kicad_pcb from above]

Board: 4 copper layers, 60.5 x 55.5 mm, 61 parts (0 on the bottom side), 39 nets.

Parts:
C1, C17, C18, C19, C20, C21, C22, C23: 47u; C_47u_CAPC3216X180N
C2: 1u; C_1u_CAPC1005X55N
C3, C4, C5, C6, C7, C14, C15, C16: 100n; C_100n_CAPC1608X80N
C8, C9: 2u2; C_2u2_CAPC2012X145N
C10, C11, C12, C13: 10p; C_10p_CAPC1608X80N
D1: DF2S23P2FU,H3F; Diode_TVS_SOD2513X115N
H1, H2, H3: MountingHole; MountingHole_3.2mm_M3
IC1: regulateur_3V3_1A_TLV76133DCYR; regulateur_3V3_1A_SOT230P700X180-4N
IC2: LM7805MPX_NOPB; regulateur_5V_SOT230P700X180-4N
J1: PJ-114AH-SMT-TR; PowerJackCon_PJ114AHSMTTR
J3: Conn_02x04_Odd_Even; PinSocket_2x04_P2.54mm_Vertical_fliped
J4: Conn_01x08_Pin; PinSocket_1x08_P2.54mm_Vertical
J5: Conn_ARM_JTAG_SWD_10; PinHeader_2x05_P1.27mm_Vertical_SMD
LED1: Rouge; led_verte_T-1_3MM_
LED2, LED3, LED4, LED5, LED6: Verte; led_verte_T-1_3MM_
R1, R2, R3, R4, R15, R16, R17, R18: 1k; R_0603_1608Metric_Pad0.98x0.95mm_HandSolder
R5, R6, R7, R8: 82; R_0603_1608Metric_Pad0.98x0.95mm_HandSolder
R9, R10, R11, R12, R13, R14: 10K; R_1206_3216Metric_Pad1.30x1.75mm_HandSolder
S1, S2: DS01C-254-L-03BE; switch_3_DS01C254L03BE
U1: STM32H523CET6; MCU_QFP50P900X900X160-48N
Y1: CX3225FB40000F0FZZH1; Crystal_SMD_3225-4Pin_3.2x2.5mm_HandSoldering

Connections:
+3.3V: C1.1, C2.2, C3.1, C4.1, C5.1, C6.1, C7.1, C21.1, C22.1, C23.1, IC1.2 (OUT_1), IC1.4 (OUT_2), J3.2 (VCC), J4.1, J5.1 (VTref), R1.1, R2.1, R9.1, R17.1, R18.1, S1.3 (COM_{1}), S1.5 (COM_{2}), S2.1 (COM_{0}), S2.3 (COM_{1}), S2.5 (COM_{2}), U1.1 (VBAT), U1.9 (VDDA), U1.24 (VDD_1), U1.36 (VDD_2), U1.48 (VDD_3)
+5V: C19.1, C20.1, IC1.3 (IN), IC2.3 (OUTPUT), J4.5, R15.1, R16.1
+9/28V: C17.1, C18.1, D1.1 (K), IC2.1 (INPUT), J1.+
/Émetteur caméra/BootMode: R10.2, S1.4 (NO_{1}), U1.44 (BOOT0)
/Émetteur caméra/HSE_0: C10.1, C11.1, U1.5 (OSC_IN), Y1.3
/Émetteur caméra/HSE_1: C12.1, C13.1, U1.6 (OSC_OUT), Y1.1
/Émetteur caméra/I2C_{2}_SCL: J4.8, R4.2, U1.21 (PB10)
/Émetteur caméra/I2C_{2}_SDA: J4.7, R3.2, U1.25 (PB12)
/Émetteur caméra/IRQ_{0}: J3.8 (IRQ), U1.11 (PA1)
/Émetteur caméra/JTCK/SWCLK: J5.4 (SWCLK/TCK), U1.37 (PA14)
/Émetteur caméra/JTDI: J5.8 (NC/TDI), U1.38 (PA15)
/Émetteur caméra/JTDO: J5.6 (SWO/TDO), U1.39 (PB3)
/Émetteur caméra/JTMS/SWDIO: J5.2 (SWDIO/TMS), U1.34 (PA13)
/Émetteur caméra/JTNRST: J5.10 (~RESET), U1.40 (PB4)
/Émetteur caméra/SPI_{1}_MISO: J4.4, U1.16 (PA6)
/Émetteur caméra/SPI_{1}_MOSI: J4.3, U1.17 (PA7)
/Émetteur caméra/SPI_{1}_SCLK: J4.2, U1.15 (PA5)
/Émetteur caméra/SPI_{2}_MISO: J3.6 (MOSI), U1.27 (PB14)
/Émetteur caméra/SPI_{2}_MOSI: J3.7 (MISO), U1.28 (PB15)
/Émetteur caméra/SPI_{2}_SCLK: J3.5 (SCL), U1.26 (PB13)
/Émetteur caméra/dbgUsrLed_{0}: R5.1, U1.41 (PB5)
/Émetteur caméra/dbgUsrLed_{1}: R6.1, U1.42 (PB6)
/Émetteur caméra/dbgUsrLed_{2}: R7.1, U1.43 (PB7)
/Émetteur caméra/dbgUsrLed_{3}: R8.1, U1.45 (PB8)
/Émetteur caméra/usrCmd_{0}: R12.2, S2.2 (NO_{0}), U1.18 (PB0)
/Émetteur caméra/usrCmd_{1}: R13.2, S2.4 (NO_{1}), U1.19 (PB1)
/Émetteur caméra/usrCmd_{2}: R14.2, S2.6 (NO_{2}), U1.20 (PB2)
/Émetteur caméra/usrSubmitCmd: C15.1, C16.1, R11.2, S1.6 (NO_{2}), U1.10 (PA0)
/Émetteur caméra/~RESET: C14.1, J3.3 (CE), R9.2, S1.2 (NO_{0}), U1.7 (~RESET)
GND: C1.2, C2.1, C3.2, C4.2, C5.2, C6.2, C7.2, C8.1, C9.1, C10.2, C11.2, C12.2, C13.2, C14.2, C15.2, C16.2, C17.2, C18.2, C19.2, C20.2, C21.2, C22.2, C23.2, D1.2 (A), IC1.1 (GND), IC2.2 (GND_{1}), IC2.4 (GND_{2}), J1.-, J3.1 (GND), J3.4 (~CS), J4.6, J5.3 (GND), J5.5 (GND), J5.9 (GNDDetect), LED1.1 (K), LED2.1 (K), LED3.1 (K), LED4.1 (K), LED5.1 (K), LED6.1 (K), R10.1, R11.1, R12.1, R13.1, R14.1, S1.1 (COM_{0}), U1.8 (VSSA), U1.23 (VSS_1), U1.35 (VSS_2), U1.47 (VSS_3), Y1.2, Y1.4
unnamed: LED1.2 (A), R5.2
unnamed: LED2.2 (A), R6.2
unnamed: LED3.2 (A), R7.2
unnamed: LED4.2 (A), R8.2
unnamed: LED5.2 (A), R15.2, R16.2
unnamed: LED6.2 (A), R17.2, R18.2
unnamed: R1.2, R3.1
unnamed: R2.2, R4.1
unnamed: C8.2, C9.2, U1.22 (VCAP_1), U1.46 (VCAP_2)
