JeanPatrique/ProjetButESE/recepteur/recepteur.kicad_pcb

## KiCad design recepteur/recepteur.kicad_pcb (2026-03-14)

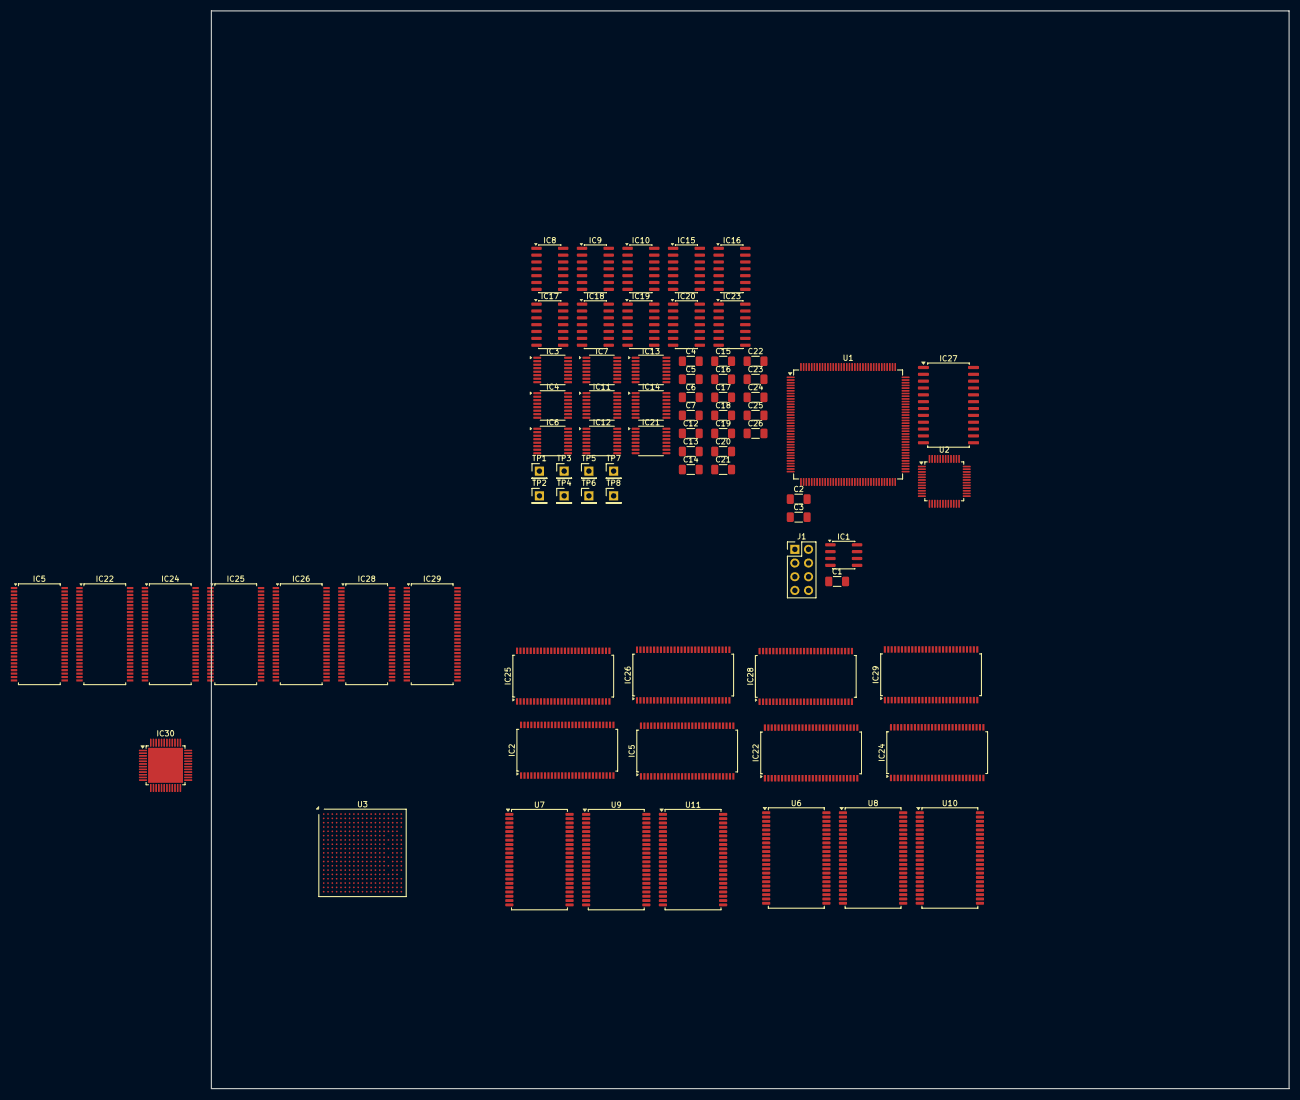
[picture p31: board recepteur.kicad_pcb from above]

Board: 2 copper layers, 200.0 x 200.0 mm, 77 parts (0 on the bottom side), 311 nets.

Parts:
C1, C2, C3: C; C_1206_3216Metric_Pad1.33x1.80mm_HandSolder
C4, C5, C6, C7, C12, C13, C14, C15, C16, C17, C18, C19, C20, C21, C22, C23, C24, C25, C26: 100nF; C_1206_3216Metric_Pad1.33x1.80mm_HandSolder
IC1: 551MLF; SOIC-8_3.9x4.9mm_P1.27mm
IC2, IC5, IC5#2, IC22, IC22#2, IC24, IC24#2, IC25, IC25#2, IC26, IC26#2, IC28, IC28#2, IC29, IC29#2: SN74CBTD16211DLR; SSOP-56_7.5x18.5mm_P0.635mm
IC3, IC4, IC6, IC7: SN74LV4040APWR; TSSOP-16_4.4x5mm_P0.65mm
IC8, IC9, IC10, IC15, IC16, IC17, IC18, IC19, IC20, IC23: SN74F21DRE4; SOIC-14_3.9x8.7mm_P1.27mm
IC11, IC12, IC13, IC14, IC21: 74VHC112; TSSOP-16_4.4x5mm_P0.65mm
IC27: SN74LVCC4245A; SOIC-24W_7.5x15.4mm_P1.27mm
IC30: THS8135PHP; Texas_PHP0048E_HTQFP-48-1EP_7x7mm_P0.5mm_EP6.5x6.5mm_Mask3.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
J1: Conn_02x04_Counter_Clockwise; PinHeader_2x04_P2.54mm_Vertical
TP1, TP2, TP3, TP4, TP5, TP6, TP7, TP8: TestPoint; PinHeader_1x01_P2.54mm_Vertical
U1: STM32H733ZGTx; LQFP-144_20x20mm_P0.5mm
U2: STM32H523CETx; LQFP-48_7x7mm_P0.5mm
U3: STM32MP151DABx; ST_LFBGA-354_16x16mm_Layout19x19_P0.8mm
U6, U7, U8, U9, U10, U11: IS61C5128AL-10TLI; TSOP-II-44_10.16x18.41mm_P0.8mm

Connections:
/MCU/40MHZ_pixel_clock: IC1.1 (ICLK), IC27.3 (A0), IC27.21 (B0)
/MCU/RESET: IC27.5 (A2), IC27.19 (B2)
/MCU/pixelBufferMemoryAddress.A_{0}: IC24#2.54 (B_{1}_1), IC28#2.54 (B_{1}_1)
/MCU/pixelBufferMemoryAddress.A_{1}: IC24#2.53 (B_{1}_2), IC28#2.53 (B_{1}_2)
/MCU/pixelBufferMemoryAddress.A_{2}: IC24#2.52 (B_{1}_3), IC28#2.52 (B_{1}_3)
/MCU/pixelBufferMemoryAddress.A_{3}: IC24#2.51 (B_{1}_4), IC28#2.51 (B_{1}_4)
/MCU/pixelBufferMemoryAddress.A_{4}: IC24#2.50 (B_{1}_5), IC28#2.50 (B_{1}_5)
/MCU/pixelBufferMemoryAddress.A_{5}: IC24#2.48 (B_{1}_6), IC28#2.48 (B_{1}_6)
/MCU/pixelBufferMemoryAddress.A_{6}: IC24#2.47 (B_{1}_7), IC28#2.47 (B_{1}_7)
/MCU/pixelBufferMemoryAddress.A_{7}: IC24#2.46 (B_{1}_8), IC28#2.46 (B_{1}_8)
/MCU/pixelBufferMemoryAddress.A_{8}: IC24#2.45 (B_{1}_9), IC28#2.45 (B_{1}_9)
/MCU/pixelBufferMemoryAddress.A_{9}: IC24#2.44 (B_{1}_10), IC28#2.44 (B_{1}_10)
/MCU/pixelBufferMemoryAddress.A_{10}: IC24#2.43 (B_{1}_11), IC28#2.43 (B_{1}_11)
/MCU/pixelBufferMemoryAddress.A_{11}: IC24#2.42 (B_{1}_12), IC28#2.42 (B_{1}_12)
/MCU/pixelBufferMemoryAddress.A_{12}: IC24#2.41 (B_{2}_1), IC28#2.41 (B_{2}_1)
/MCU/pixelBufferMemoryAddress.A_{13}: IC24#2.40 (B_{2}_2), IC28#2.40 (B_{2}_2)
/MCU/pixelBufferMemoryAddress.A_{14}: IC24#2.39 (B_{2}_3), IC28#2.39 (B_{2}_3)
/MCU/pixelBufferMemoryAddress.A_{15}: IC24#2.37 (B_{2}_4), IC28#2.37 (B_{2}_4)
/MCU/pixelBufferMemoryAddress.A_{16}: IC24#2.36 (B_{2}_5), IC28#2.36 (B_{2}_5)
/MCU/pixelBufferMemoryAddress.A_{17}: IC24#2.35 (B_{2}_6), IC28#2.35 (B_{2}_6)
/MCU/pixelBufferMemoryAddress.A_{18}: IC24#2.34 (B_{2}_7), IC28#2.34 (B_{2}_7)
/MCU/pixelBuffer~WE: IC5.33 (B_{2}_8), IC24.33 (B_{2}_8), IC24#2.33 (B_{2}_8), IC28#2.33 (B_{2}_8)
/MCU/videoBufferSwapRequest_5V: IC19.8 (&), IC23.4 (C), IC23.5 (D), TP3.1
/MCU/~MCU_ACK_bufferSwap: IC23.1 (A), IC23.2 (B), IC27.10 (A7), IC27.14 (B7)
/Memory_bank_{0}/address.A_{0}: IC22.2 (A_{1}_1), IC24#2.2 (A_{1}_1)
/Memory_bank_{0}/address.A_{1}: IC22.3 (A_{1}_2), IC24#2.3 (A_{1}_2)
/Memory_bank_{0}/address.A_{2}: IC22.4 (A_{1}_3), IC24#2.4 (A_{1}_3)
/Memory_bank_{0}/address.A_{3}: IC22.5 (A_{1}_4), IC24#2.5 (A_{1}_4)
/Memory_bank_{0}/address.A_{4}: IC22.6 (A_{1}_5), IC24#2.6 (A_{1}_5)
/Memory_bank_{0}/address.A_{5}: IC22.7 (A_{1}_6), IC24#2.7 (A_{1}_6)
/Memory_bank_{0}/address.A_{6}: IC22.9 (A_{1}_7), IC24#2.9 (A_{1}_7)
/Memory_bank_{0}/address.A_{7}: IC22.10 (A_{1}_8), IC24#2.10 (A_{1}_8)
/Memory_bank_{0}/address.A_{8}: IC22.11 (A_{1}_9), IC24#2.11 (A_{1}_9)
/Memory_bank_{0}/address.A_{9}: IC22.12 (A_{1}_10), IC24#2.12 (A_{1}_10)
/Memory_bank_{0}/address.A_{10}: IC22.13 (A_{1}_11), IC24#2.13 (A_{1}_11)
/Memory_bank_{0}/address.A_{11}: IC22.14 (A_{1}_12), IC24#2.14 (A_{1}_12)
/Memory_bank_{0}/address.A_{12}: IC22.15 (A_{2}_1), IC24#2.15 (A_{2}_1)
/Memory_bank_{0}/address.A_{13}: IC22.16 (A_{2}_2), IC24#2.16 (A_{2}_2)
/Memory_bank_{0}/address.A_{14}: IC22.18 (A_{2}_3), IC24#2.18 (A_{2}_3)
/Memory_bank_{0}/address.A_{15}: IC22.20 (A_{2}_4), IC24#2.20 (A_{2}_4)
/Memory_bank_{0}/address.A_{16}: IC22.21 (A_{2}_5), IC24#2.21 (A_{2}_5)
/Memory_bank_{0}/address.A_{17}: IC22.22 (A_{2}_6), IC24#2.22 (A_{2}_6)
/Memory_bank_{0}/address.A_{18}: IC22.23 (A_{2}_7), IC24#2.23 (A_{2}_7)
/Memory_bank_{0}/data.D_{0}: IC2.2 (A_{1}_1), IC5#2.2 (A_{1}_1), U6.9 (I/O0)
/Memory_bank_{0}/data.D_{1}: IC2.3 (A_{1}_2), IC5#2.3 (A_{1}_2), U6.10 (I/O1)
/Memory_bank_{0}/data.D_{2}: IC2.4 (A_{1}_3), IC5#2.4 (A_{1}_3), U6.13 (I/O2)
/Memory_bank_{0}/data.D_{3}: IC2.5 (A_{1}_4), IC5#2.5 (A_{1}_4), U6.14 (I/O3)
/Memory_bank_{0}/data.D_{4}: IC2.6 (A_{1}_5), IC5#2.6 (A_{1}_5), U6.31 (I/O4)
/Memory_bank_{0}/data.D_{5}: IC2.7 (A_{1}_6), IC5#2.7 (A_{1}_6), U6.32 (I/O5)
/Memory_bank_{0}/data.D_{6}: IC2.9 (A_{1}_7), IC5#2.9 (A_{1}_7), U6.35 (I/O6)
/Memory_bank_{0}/data.D_{7}: IC2.10 (A_{1}_8), IC5#2.10 (A_{1}_8), U6.36 (I/O7)
/Memory_bank_{0}/data.D_{8}: IC2.11 (A_{1}_9), IC5#2.11 (A_{1}_9), U8.9 (I/O0)
/Memory_bank_{0}/data.D_{9}: IC2.12 (A_{1}_10), IC5#2.12 (A_{1}_10), U8.10 (I/O1)
/Memory_bank_{0}/data.D_{10}: IC2.13 (A_{1}_11), IC5#2.13 (A_{1}_11), U8.13 (I/O2)
/Memory_bank_{0}/data.D_{11}: IC2.14 (A_{1}_12), IC5#2.14 (A_{1}_12), U8.14 (I/O3)
/Memory_bank_{0}/data.D_{12}: IC2.15 (A_{2}_1), IC5#2.15 (A_{2}_1), U8.31 (I/O4)
/Memory_bank_{0}/data.D_{13}: IC2.16 (A_{2}_2), IC5#2.16 (A_{2}_2), U8.32 (I/O5)
/Memory_bank_{0}/data.D_{14}: IC2.18 (A_{2}_3), IC5#2.18 (A_{2}_3), U8.35 (I/O6)
/Memory_bank_{0}/data.D_{15}: IC2.20 (A_{2}_4), IC5#2.20 (A_{2}_4), U8.36 (I/O7)
/Memory_bank_{0}/data.D_{16}: IC2.21 (A_{2}_5), IC5#2.21 (A_{2}_5), U10.9 (I/O0)
/Memory_bank_{0}/data.D_{17}: IC2.22 (A_{2}_6), IC5#2.22 (A_{2}_6), U10.10 (I/O1)
/Memory_bank_{0}/data.D_{18}: IC2.23 (A_{2}_7), IC5#2.23 (A_{2}_7), U10.13 (I/O2)
/Memory_bank_{0}/data.D_{19}: IC2.24 (A_{2}_8), IC5#2.24 (A_{2}_8), U10.14 (I/O3)
/Memory_bank_{0}/data.D_{20}: IC2.25 (A_{2}_9), IC5#2.25 (A_{2}_9), U10.31 (I/O4)
/Memory_bank_{0}/data.D_{21}: IC2.26 (A_{2}_10), IC5#2.26 (A_{2}_10), U10.32 (I/O5)
/Memory_bank_{0}/data.D_{22}: IC2.27 (A_{2}_11), IC5#2.27 (A_{2}_11), U10.35 (I/O6)
/Memory_bank_{0}/data.D_{23}: IC2.28 (A_{2}_12), IC5#2.28 (A_{2}_12), U10.36 (I/O7)
/Memory_bank_{0}/pixelMemoryAddress.A_{0}: U6.3 (A0), U8.3 (A0), U10.3 (A0)
/Memory_bank_{0}/pixelMemoryAddress.A_{1}: U6.4 (A1), U8.4 (A1), U10.4 (A1)
/Memory_bank_{0}/pixelMemoryAddress.A_{2}: U6.5 (A2), U8.5 (A2), U10.5 (A2)
/Memory_bank_{0}/pixelMemoryAddress.A_{3}: U6.6 (A3), U8.6 (A3), U10.6 (A3)
/Memory_bank_{0}/pixelMemoryAddress.A_{4}: U6.7 (A4), U8.7 (A4), U10.7 (A4)
/Memory_bank_{0}/pixelMemoryAddress.A_{5}: U6.16 (A5), U8.16 (A5), U10.16 (A5)
/Memory_bank_{0}/pixelMemoryAddress.A_{6}: U6.17 (A6), U8.17 (A6), U10.17 (A6)
/Memory_bank_{0}/pixelMemoryAddress.A_{7}: U6.18 (A7), U8.18 (A7), U10.18 (A7)
/Memory_bank_{0}/pixelMemoryAddress.A_{8}: U6.19 (A8), U8.19 (A8), U10.19 (A8)
/Memory_bank_{0}/pixelMemoryAddress.A_{9}: U6.20 (A9), U8.20 (A9), U10.20 (A9)
/Memory_bank_{0}/pixelMemoryAddress.A_{10}: U6.26 (A10), U8.26 (A10), U10.26 (A10)
/Memory_bank_{0}/pixelMemoryAddress.A_{11}: U6.27 (A11), U8.27 (A11), U10.27 (A11)
/Memory_bank_{0}/pixelMemoryAddress.A_{12}: U6.28 (A12), U8.28 (A12), U10.28 (A12)
/Memory_bank_{0}/pixelMemoryAddress.A_{13}: U6.29 (A13), U8.29 (A13), U10.29 (A13)
/Memory_bank_{0}/pixelMemoryAddress.A_{14}: U6.30 (A14), U8.30 (A14), U10.30 (A14)
/Memory_bank_{0}/pixelMemoryAddress.A_{15}: U6.38 (A15), U8.38 (A15), U10.38 (A15)
/Memory_bank_{0}/pixelMemoryAddress.A_{16}: U6.39 (A16), U8.39 (A16), U10.39 (A16)
/Memory_bank_{0}/pixelMemoryAddress.A_{17}: U6.40 (A17), U8.40 (A17), U10.40 (A17)
/Memory_bank_{0}/pixelMemoryAddress.A_{18}: U6.41 (A18), U8.41 (A18), U10.41 (A18)
/Memory_bank_{1}/address.A_{0}: IC28#2.2 (A_{1}_1), IC29#2.2 (A_{1}_1)
/Memory_bank_{1}/address.A_{1}: IC28#2.3 (A_{1}_2), IC29#2.3 (A_{1}_2)
/Memory_bank_{1}/address.A_{2}: IC28#2.4 (A_{1}_3), IC29#2.4 (A_{1}_3)
/Memory_bank_{1}/address.A_{3}: IC28#2.5 (A_{1}_4), IC29#2.5 (A_{1}_4)
/Memory_bank_{1}/address.A_{4}: IC28#2.6 (A_{1}_5), IC29#2.6 (A_{1}_5)
/Memory_bank_{1}/address.A_{5}: IC28#2.7 (A_{1}_6), IC29#2.7 (A_{1}_6)
/Memory_bank_{1}/address.A_{6}: IC28#2.9 (A_{1}_7), IC29#2.9 (A_{1}_7)
/Memory_bank_{1}/address.A_{7}: IC28#2.10 (A_{1}_8), IC29#2.10 (A_{1}_8)
/Memory_bank_{1}/address.A_{8}: IC28#2.11 (A_{1}_9), IC29#2.11 (A_{1}_9)
/Memory_bank_{1}/address.A_{9}: IC28#2.12 (A_{1}_10), IC29#2.12 (A_{1}_10)
/Memory_bank_{1}/address.A_{10}: IC28#2.13 (A_{1}_11), IC29#2.13 (A_{1}_11)
/Memory_bank_{1}/address.A_{11}: IC28#2.14 (A_{1}_12), IC29#2.14 (A_{1}_12)
/Memory_bank_{1}/address.A_{12}: IC28#2.15 (A_{2}_1), IC29#2.15 (A_{2}_1)
/Memory_bank_{1}/address.A_{13}: IC28#2.16 (A_{2}_2), IC29#2.16 (A_{2}_2)
/Memory_bank_{1}/address.A_{14}: IC28#2.18 (A_{2}_3), IC29#2.18 (A_{2}_3)
/Memory_bank_{1}/address.A_{15}: IC28#2.20 (A_{2}_4), IC29#2.20 (A_{2}_4)
/Memory_bank_{1}/address.A_{16}: IC28#2.21 (A_{2}_5), IC29#2.21 (A_{2}_5)
/Memory_bank_{1}/address.A_{17}: IC28#2.22 (A_{2}_6), IC29#2.22 (A_{2}_6)
/Memory_bank_{1}/address.A_{18}: IC28#2.23 (A_{2}_7), IC29#2.23 (A_{2}_7)
/Memory_bank_{1}/data.D_{0}: IC25#2.2 (A_{1}_1), IC26.2 (A_{1}_1), U7.9 (I/O0)
/Memory_bank_{1}/data.D_{1}: IC25#2.3 (A_{1}_2), IC26.3 (A_{1}_2), U7.10 (I/O1)
/Memory_bank_{1}/data.D_{2}: IC25#2.4 (A_{1}_3), IC26.4 (A_{1}_3), U7.13 (I/O2)
/Memory_bank_{1}/data.D_{3}: IC25#2.5 (A_{1}_4), IC26.5 (A_{1}_4), U7.14 (I/O3)
/Memory_bank_{1}/data.D_{4}: IC25#2.6 (A_{1}_5), IC26.6 (A_{1}_5), U7.31 (I/O4)
/Memory_bank_{1}/data.D_{5}: IC25#2.7 (A_{1}_6), IC26.7 (A_{1}_6), U7.32 (I/O5)
/Memory_bank_{1}/data.D_{6}: IC25#2.9 (A_{1}_7), IC26.9 (A_{1}_7), U7.35 (I/O6)
/Memory_bank_{1}/data.D_{7}: IC25#2.10 (A_{1}_8), IC26.10 (A_{1}_8), U7.36 (I/O7)
/Memory_bank_{1}/data.D_{8}: IC25#2.11 (A_{1}_9), IC26.11 (A_{1}_9), U9.9 (I/O0)
/Memory_bank_{1}/data.D_{9}: IC25#2.12 (A_{1}_10), IC26.12 (A_{1}_10), U9.10 (I/O1)
/Memory_bank_{1}/data.D_{10}: IC25#2.13 (A_{1}_11), IC26.13 (A_{1}_11), U9.13 (I/O2)
/Memory_bank_{1}/data.D_{11}: IC25#2.14 (A_{1}_12), IC26.14 (A_{1}_12), U9.14 (I/O3)
/Memory_bank_{1}/data.D_{12}: IC25#2.15 (A_{2}_1), IC26.15 (A_{2}_1), U9.31 (I/O4)
/Memory_bank_{1}/data.D_{13}: IC25#2.16 (A_{2}_2), IC26.16 (A_{2}_2), U9.32 (I/O5)
/Memory_bank_{1}/data.D_{14}: IC25#2.18 (A_{2}_3), IC26.18 (A_{2}_3), U9.35 (I/O6)
/Memory_bank_{1}/data.D_{15}: IC25#2.20 (A_{2}_4), IC26.20 (A_{2}_4), U9.36 (I/O7)
/Memory_bank_{1}/data.D_{16}: IC25#2.21 (A_{2}_5), IC26.21 (A_{2}_5), U11.9 (I/O0)
/Memory_bank_{1}/data.D_{17}: IC25#2.22 (A_{2}_6), IC26.22 (A_{2}_6), U11.10 (I/O1)
/Memory_bank_{1}/data.D_{18}: IC25#2.23 (A_{2}_7), IC26.23 (A_{2}_7), U11.13 (I/O2)
/Memory_bank_{1}/data.D_{19}: IC25#2.24 (A_{2}_8), IC26.24 (A_{2}_8), U11.14 (I/O3)
/Memory_bank_{1}/data.D_{20}: IC25#2.25 (A_{2}_9), IC26.25 (A_{2}_9), U11.31 (I/O4)
/Memory_bank_{1}/data.D_{21}: IC25#2.26 (A_{2}_10), IC26.26 (A_{2}_10), U11.32 (I/O5)
/Memory_bank_{1}/data.D_{22}: IC25#2.27 (A_{2}_11), IC26.27 (A_{2}_11), U11.35 (I/O6)
/Memory_bank_{1}/data.D_{23}: IC25#2.28 (A_{2}_12), IC26.28 (A_{2}_12), U11.36 (I/O7)
/Memory_bank_{1}/pixelMemoryAddress.A_{0}: U7.3 (A0), U9.3 (A0), U11.3 (A0)
/Memory_bank_{1}/pixelMemoryAddress.A_{1}: U7.4 (A1), U9.4 (A1), U11.4 (A1)
/Memory_bank_{1}/pixelMemoryAddress.A_{2}: U7.5 (A2), U9.5 (A2), U11.5 (A2)
/Memory_bank_{1}/pixelMemoryAddress.A_{3}: U7.6 (A3), U9.6 (A3), U11.6 (A3)
/Memory_bank_{1}/pixelMemoryAddress.A_{4}: U7.7 (A4), U9.7 (A4), U11.7 (A4)
/Memory_bank_{1}/pixelMemoryAddress.A_{5}: U7.16 (A5), U9.16 (A5), U11.16 (A5)
/Memory_bank_{1}/pixelMemoryAddress.A_{6}: U7.17 (A6), U9.17 (A6), U11.17 (A6)
/Memory_bank_{1}/pixelMemoryAddress.A_{7}: U7.18 (A7), U9.18 (A7), U11.18 (A7)
/Memory_bank_{1}/pixelMemoryAddress.A_{8}: U7.19 (A8), U9.19 (A8), U11.19 (A8)
/Memory_bank_{1}/pixelMemoryAddress.A_{9}: U7.20 (A9), U9.20 (A9), U11.20 (A9)
/Memory_bank_{1}/pixelMemoryAddress.A_{10}: U7.26 (A10), U9.26 (A10), U11.26 (A10)
/Memory_bank_{1}/pixelMemoryAddress.A_{11}: U7.27 (A11), U9.27 (A11), U11.27 (A11)
/Memory_bank_{1}/pixelMemoryAddress.A_{12}: U7.28 (A12), U9.28 (A12), U11.28 (A12)
/Memory_bank_{1}/pixelMemoryAddress.A_{13}: U7.29 (A13), U9.29 (A13), U11.29 (A13)
/Memory_bank_{1}/pixelMemoryAddress.A_{14}: U7.30 (A14), U9.30 (A14), U11.30 (A14)
/Memory_bank_{1}/pixelMemoryAddress.A_{15}: U7.38 (A15), U9.38 (A15), U11.38 (A15)
/Memory_bank_{1}/pixelMemoryAddress.A_{16}: U7.39 (A16), U9.39 (A16), U11.39 (A16)
/Memory_bank_{1}/pixelMemoryAddress.A_{17}: U7.40 (A17), U9.40 (A17), U11.40 (A17)
/Memory_bank_{1}/pixelMemoryAddress.A_{18}: U7.41 (A18), U9.41 (A18), U11.41 (A18)
/VGA_controller/Buffer_pixelAddress.A_{0}: IC5.2 (A_{1}_1), IC5.54 (B_{1}_1), IC22.54 (B_{1}_1), IC24.2 (A_{1}_1), IC24.54 (B_{1}_1), IC26#2.2 (A_{1}_1), IC26#2.54 (B_{1}_1), IC29.2 (A_{1}_1), IC29.54 (B_{1}_1), IC29#2.54 (B_{1}_1)
/VGA_controller/Buffer_pixelAddress.A_{1}: IC5.3 (A_{1}_2), IC5.53 (B_{1}_2), IC22.53 (B_{1}_2), IC24.3 (A_{1}_2), IC24.53 (B_{1}_2), IC26#2.3 (A_{1}_2), IC26#2.53 (B_{1}_2), IC29.3 (A_{1}_2), IC29.53 (B_{1}_2), IC29#2.53 (B_{1}_2)
/VGA_controller/Buffer_pixelAddress.A_{2}: IC5.4 (A_{1}_3), IC5.52 (B_{1}_3), IC22.52 (B_{1}_3), IC24.4 (A_{1}_3), IC24.52 (B_{1}_3), IC26#2.4 (A_{1}_3), IC26#2.52 (B_{1}_3), IC29.4 (A_{1}_3), IC29.52 (B_{1}_3), IC29#2.52 (B_{1}_3)
/VGA_controller/Buffer_pixelAddress.A_{3}: IC5.5 (A_{1}_4), IC5.51 (B_{1}_4), IC22.51 (B_{1}_4), IC24.5 (A_{1}_4), IC24.51 (B_{1}_4), IC26#2.5 (A_{1}_4), IC26#2.51 (B_{1}_4), IC29.5 (A_{1}_4), IC29.51 (B_{1}_4), IC29#2.51 (B_{1}_4)
/VGA_controller/Buffer_pixelAddress.A_{4}: IC5.6 (A_{1}_5), IC5.50 (B_{1}_5), IC22.50 (B_{1}_5), IC24.6 (A_{1}_5), IC24.50 (B_{1}_5), IC26#2.6 (A_{1}_5), IC26#2.50 (B_{1}_5), IC29.6 (A_{1}_5), IC29.50 (B_{1}_5), IC29#2.50 (B_{1}_5)
/VGA_controller/Buffer_pixelAddress.A_{5}: IC5.7 (A_{1}_6), IC5.48 (B_{1}_6), IC22.48 (B_{1}_6), IC24.7 (A_{1}_6), IC24.48 (B_{1}_6), IC26#2.7 (A_{1}_6), IC26#2.48 (B_{1}_6), IC29.7 (A_{1}_6), IC29.48 (B_{1}_6), IC29#2.48 (B_{1}_6)
/VGA_controller/Buffer_pixelAddress.A_{6}: IC5.9 (A_{1}_7), IC5.47 (B_{1}_7), IC22.47 (B_{1}_7), IC24.9 (A_{1}_7), IC24.47 (B_{1}_7), IC26#2.9 (A_{1}_7), IC26#2.47 (B_{1}_7), IC29.9 (A_{1}_7), IC29.47 (B_{1}_7), IC29#2.47 (B_{1}_7)
/VGA_controller/Buffer_pixelAddress.A_{7}: IC5.10 (A_{1}_8), IC5.46 (B_{1}_8), IC22.46 (B_{1}_8), IC24.10 (A_{1}_8), IC24.46 (B_{1}_8), IC26#2.10 (A_{1}_8), IC26#2.46 (B_{1}_8), IC29.10 (A_{1}_8), IC29.46 (B_{1}_8), IC29#2.46 (B_{1}_8)
/VGA_controller/Buffer_pixelAddress.A_{8}: IC5.11 (A_{1}_9), IC5.45 (B_{1}_9), IC22.45 (B_{1}_9), IC24.11 (A_{1}_9), IC24.45 (B_{1}_9), IC26#2.11 (A_{1}_9), IC26#2.45 (B_{1}_9), IC29.11 (A_{1}_9), IC29.45 (B_{1}_9), IC29#2.45 (B_{1}_9)
/VGA_controller/Buffer_pixelAddress.A_{9}: IC5.12 (A_{1}_10), IC5.44 (B_{1}_10), IC22.44 (B_{1}_10), IC24.12 (A_{1}_10), IC24.44 (B_{1}_10), IC26#2.12 (A_{1}_10), IC26#2.44 (B_{1}_10), IC29.12 (A_{1}_10), IC29.44 (B_{1}_10), IC29#2.44 (B_{1}_10)
/VGA_controller/Buffer_pixelAddress.A_{10}: IC5.13 (A_{1}_11), IC5.43 (B_{1}_11), IC22.43 (B_{1}_11), IC24.13 (A_{1}_11), IC24.43 (B_{1}_11), IC26#2.13 (A_{1}_11), IC26#2.43 (B_{1}_11), IC29.13 (A_{1}_11), IC29.43 (B_{1}_11), IC29#2.43 (B_{1}_11)
/VGA_controller/Buffer_pixelAddress.A_{11}: IC5.14 (A_{1}_12), IC5.42 (B_{1}_12), IC22.42 (B_{1}_12), IC24.14 (A_{1}_12), IC24.42 (B_{1}_12), IC26#2.14 (A_{1}_12), IC26#2.42 (B_{1}_12), IC29.14 (A_{1}_12), IC29.42 (B_{1}_12), IC29#2.42 (B_{1}_12)
/VGA_controller/Buffer_pixelAddress.A_{12}: IC5.15 (A_{2}_1), IC5.41 (B_{2}_1), IC22.41 (B_{2}_1), IC24.15 (A_{2}_1), IC24.41 (B_{2}_1), IC26#2.15 (A_{2}_1), IC26#2.41 (B_{2}_1), IC29.15 (A_{2}_1), IC29.41 (B_{2}_1), IC29#2.41 (B_{2}_1)
/VGA_controller/Buffer_pixelAddress.A_{13}: IC5.16 (A_{2}_2), IC5.40 (B_{2}_2), IC22.40 (B_{2}_2), IC24.16 (A_{2}_2), IC24.40 (B_{2}_2), IC26#2.16 (A_{2}_2), IC26#2.40 (B_{2}_2), IC29.16 (A_{2}_2), IC29.40 (B_{2}_2), IC29#2.40 (B_{2}_2)
/VGA_controller/Buffer_pixelAddress.A_{14}: IC5.18 (A_{2}_3), IC5.39 (B_{2}_3), IC22.39 (B_{2}_3), IC24.18 (A_{2}_3), IC24.39 (B_{2}_3), IC26#2.18 (A_{2}_3), IC26#2.39 (B_{2}_3), IC29.18 (A_{2}_3), IC29.39 (B_{2}_3), IC29#2.39 (B_{2}_3)
/VGA_controller/Buffer_pixelAddress.A_{15}: IC5.20 (A_{2}_4), IC5.37 (B_{2}_4), IC22.37 (B_{2}_4), IC24.20 (A_{2}_4), IC24.37 (B_{2}_4), IC26#2.20 (A_{2}_4), IC26#2.37 (B_{2}_4), IC29.20 (A_{2}_4), IC29.37 (B_{2}_4), IC29#2.37 (B_{2}_4)
/VGA_controller/Buffer_pixelAddress.A_{16}: IC5.21 (A_{2}_5), IC5.36 (B_{2}_5), IC22.36 (B_{2}_5), IC24.21 (A_{2}_5), IC24.36 (B_{2}_5), IC26#2.21 (A_{2}_5), IC26#2.36 (B_{2}_5), IC29.21 (A_{2}_5), IC29.36 (B_{2}_5), IC29#2.36 (B_{2}_5)
/VGA_controller/Buffer_pixelAddress.A_{17}: IC5.22 (A_{2}_6), IC5.35 (B_{2}_6), IC22.35 (B_{2}_6), IC24.22 (A_{2}_6), IC24.35 (B_{2}_6), IC26#2.22 (A_{2}_6), IC26#2.35 (B_{2}_6), IC29.22 (A_{2}_6), IC29.35 (B_{2}_6), IC29#2.35 (B_{2}_6)
/VGA_controller/Buffer_pixelAddress.A_{18}: IC5.23 (A_{2}_7), IC5.34 (B_{2}_7), IC22.34 (B_{2}_7), IC24.23 (A_{2}_7), IC24.34 (B_{2}_7), IC26#2.23 (A_{2}_7), IC26#2.34 (B_{2}_7), IC29.23 (A_{2}_7), IC29.34 (B_{2}_7), IC29#2.34 (B_{2}_7)
/VGA_controller/Buffer_pixelData.A_{0}: IC22#2.2 (A_{1}_1), IC22#2.54 (B_{1}_1), IC25.2 (A_{1}_1), IC25.54 (B_{1}_1), IC28.2 (A_{1}_1), IC28.54 (B_{1}_1)
/VGA_controller/Buffer_pixelData.A_{1}: IC22#2.3 (A_{1}_2), IC22#2.53 (B_{1}_2), IC25.3 (A_{1}_2), IC25.53 (B_{1}_2), IC28.3 (A_{1}_2), IC28.53 (B_{1}_2)
/VGA_controller/Buffer_pixelData.A_{2}: IC22#2.4 (A_{1}_3), IC22#2.52 (B_{1}_3), IC25.4 (A_{1}_3), IC25.52 (B_{1}_3), IC28.4 (A_{1}_3), IC28.52 (B_{1}_3)
/VGA_controller/Buffer_pixelData.A_{3}: IC22#2.5 (A_{1}_4), IC22#2.51 (B_{1}_4), IC25.5 (A_{1}_4), IC25.51 (B_{1}_4), IC28.5 (A_{1}_4), IC28.51 (B_{1}_4)
/VGA_controller/Buffer_pixelData.A_{4}: IC22#2.6 (A_{1}_5), IC22#2.50 (B_{1}_5), IC25.6 (A_{1}_5), IC25.50 (B_{1}_5), IC28.6 (A_{1}_5), IC28.50 (B_{1}_5)
/VGA_controller/Buffer_pixelData.A_{5}: IC22#2.7 (A_{1}_6), IC22#2.48 (B_{1}_6), IC25.7 (A_{1}_6), IC25.48 (B_{1}_6), IC28.7 (A_{1}_6), IC28.48 (B_{1}_6)
/VGA_controller/Buffer_pixelData.A_{6}: IC22#2.9 (A_{1}_7), IC22#2.47 (B_{1}_7), IC25.9 (A_{1}_7), IC25.47 (B_{1}_7), IC28.9 (A_{1}_7), IC28.47 (B_{1}_7)
/VGA_controller/Buffer_pixelData.A_{7}: IC22#2.10 (A_{1}_8), IC22#2.46 (B_{1}_8), IC25.10 (A_{1}_8), IC25.46 (B_{1}_8), IC28.10 (A_{1}_8), IC28.46 (B_{1}_8)
/VGA_controller/Buffer_pixelData.A_{8}: IC22#2.11 (A_{1}_9), IC22#2.45 (B_{1}_9), IC25.11 (A_{1}_9), IC25.45 (B_{1}_9), IC28.11 (A_{1}_9), IC28.45 (B_{1}_9)
/VGA_controller/Buffer_pixelData.A_{9}: IC22#2.12 (A_{1}_10), IC22#2.44 (B_{1}_10), IC25.12 (A_{1}_10), IC25.44 (B_{1}_10), IC28.12 (A_{1}_10), IC28.44 (B_{1}_10)
/VGA_controller/Buffer_pixelData.A_{10}: IC22#2.13 (A_{1}_11), IC22#2.43 (B_{1}_11), IC25.13 (A_{1}_11), IC25.43 (B_{1}_11), IC28.13 (A_{1}_11), IC28.43 (B_{1}_11)
/VGA_controller/Buffer_pixelData.A_{11}: IC22#2.14 (A_{1}_12), IC22#2.42 (B_{1}_12), IC25.14 (A_{1}_12), IC25.42 (B_{1}_12), IC28.14 (A_{1}_12), IC28.42 (B_{1}_12)
/VGA_controller/Buffer_pixelData.A_{12}: IC22#2.15 (A_{2}_1), IC22#2.41 (B_{2}_1), IC25.15 (A_{2}_1), IC25.41 (B_{2}_1), IC28.15 (A_{2}_1), IC28.41 (B_{2}_1)
/VGA_controller/Buffer_pixelData.A_{13}: IC22#2.16 (A_{2}_2), IC22#2.40 (B_{2}_2), IC25.16 (A_{2}_2), IC25.40 (B_{2}_2), IC28.16 (A_{2}_2), IC28.40 (B_{2}_2)
/VGA_controller/Buffer_pixelData.A_{14}: IC22#2.18 (A_{2}_3), IC22#2.39 (B_{2}_3), IC25.18 (A_{2}_3), IC25.39 (B_{2}_3), IC28.18 (A_{2}_3), IC28.39 (B_{2}_3)
/VGA_controller/Buffer_pixelData.A_{15}: IC22#2.20 (A_{2}_4), IC22#2.37 (B_{2}_4), IC25.20 (A_{2}_4), IC25.37 (B_{2}_4), IC28.20 (A_{2}_4), IC28.37 (B_{2}_4)
/VGA_controller/Buffer_pixelData.A_{16}: IC22#2.21 (A_{2}_5), IC22#2.36 (B_{2}_5), IC25.21 (A_{2}_5), IC25.36 (B_{2}_5), IC28.21 (A_{2}_5), IC28.36 (B_{2}_5)
/VGA_controller/Buffer_pixelData.A_{17}: IC22#2.22 (A_{2}_6), IC22#2.35 (B_{2}_6), IC25.22 (A_{2}_6), IC25.35 (B_{2}_6), IC28.22 (A_{2}_6), IC28.35 (B_{2}_6)
/VGA_controller/Buffer_pixelData.A_{18}: IC22#2.23 (A_{2}_7), IC22#2.34 (B_{2}_7), IC25.23 (A_{2}_7), IC25.34 (B_{2}_7), IC28.23 (A_{2}_7), IC28.34 (B_{2}_7)
/VGA_controller/Buffer_pixelData.A_{19}: IC22#2.24 (A_{2}_8), IC22#2.33 (B_{2}_8), IC25.24 (A_{2}_8), IC25.33 (B_{2}_8), IC28.24 (A_{2}_8), IC28.33 (B_{2}_8)
/VGA_controller/Buffer_pixelData.A_{20}: IC22#2.25 (A_{2}_9), IC22#2.32 (B_{2}_9), IC25.25 (A_{2}_9), IC25.32 (B_{2}_9), IC28.25 (A_{2}_9), IC28.32 (B_{2}_9)
/VGA_controller/Buffer_pixelData.A_{21}: IC22#2.26 (A_{2}_10), IC22#2.31 (B_{2}_10), IC25.26 (A_{2}_10), IC25.31 (B_{2}_10), IC28.26 (A_{2}_10), IC28.31 (B_{2}_10)
/VGA_controller/Buffer_pixelData.A_{22}: IC22#2.27 (A_{2}_11), IC22#2.30 (B_{2}_11), IC25.27 (A_{2}_11), IC25.30 (B_{2}_11), IC28.27 (A_{2}_11), IC28.30 (B_{2}_11)
/VGA_controller/Buffer_pixelData.A_{23}: IC22#2.28 (A_{2}_12), IC22#2.29 (B_{2}_12), IC25.28 (A_{2}_12), IC25.29 (B_{2}_12), IC28.28 (A_{2}_12), IC28.29 (B_{2}_12)
/VGA_controller/Buffer_pixelData.D_{0}: IC2.54 (B_{1}_1), IC26.54 (B_{1}_1)
/VGA_controller/Buffer_pixelData.D_{1}: IC2.53 (B_{1}_2), IC26.53 (B_{1}_2)
/VGA_controller/Buffer_pixelData.D_{2}: IC2.52 (B_{1}_3), IC26.52 (B_{1}_3)
/VGA_controller/Buffer_pixelData.D_{3}: IC2.51 (B_{1}_4), IC26.51 (B_{1}_4)
/VGA_controller/Buffer_pixelData.D_{4}: IC2.50 (B_{1}_5), IC26.50 (B_{1}_5)
/VGA_controller/Buffer_pixelData.D_{5}: IC2.48 (B_{1}_6), IC26.48 (B_{1}_6)
/VGA_controller/Buffer_pixelData.D_{6}: IC2.47 (B_{1}_7), IC26.47 (B_{1}_7)
/VGA_controller/Buffer_pixelData.D_{7}: IC2.46 (B_{1}_8), IC26.46 (B_{1}_8)
/VGA_controller/Buffer_pixelData.D_{8}: IC2.45 (B_{1}_9), IC26.45 (B_{1}_9)
/VGA_controller/Buffer_pixelData.D_{9}: IC2.44 (B_{1}_10), IC26.44 (B_{1}_10)
/VGA_controller/Buffer_pixelData.D_{10}: IC2.43 (B_{1}_11), IC26.43 (B_{1}_11)
/VGA_controller/Buffer_pixelData.D_{11}: IC2.42 (B_{1}_12), IC26.42 (B_{1}_12)
/VGA_controller/Buffer_pixelData.D_{12}: IC2.41 (B_{2}_1), IC26.41 (B_{2}_1)
/VGA_controller/Buffer_pixelData.D_{13}: IC2.40 (B_{2}_2), IC26.40 (B_{2}_2)
/VGA_controller/Buffer_pixelData.D_{14}: IC2.39 (B_{2}_3), IC26.39 (B_{2}_3)
/VGA_controller/Buffer_pixelData.D_{15}: IC2.37 (B_{2}_4), IC26.37 (B_{2}_4)
/VGA_controller/Buffer_pixelData.D_{16}: IC2.36 (B_{2}_5), IC26.36 (B_{2}_5)
/VGA_controller/Buffer_pixelData.D_{17}: IC2.35 (B_{2}_6), IC26.35 (B_{2}_6)
/VGA_controller/Buffer_pixelData.D_{18}: IC2.34 (B_{2}_7), IC26.34 (B_{2}_7)
/VGA_controller/Buffer_pixelData.D_{19}: IC2.33 (B_{2}_8), IC26.33 (B_{2}_8)
/VGA_controller/Buffer_pixelData.D_{20}: IC2.32 (B_{2}_9), IC26.32 (B_{2}_9)
/VGA_controller/Buffer_pixelData.D_{21}: IC2.31 (B_{2}_10), IC26.31 (B_{2}_10)
/VGA_controller/Buffer_pixelData.D_{22}: IC2.30 (B_{2}_11), IC26.30 (B_{2}_11)
/VGA_controller/Buffer_pixelData.D_{23}: IC2.29 (B_{2}_12), IC26.29 (B_{2}_12)
/VGA_signals_timing_generator/10Mhz_VGA_clock: IC11.1 (~CLK), IC11.13 (~CLK), IC12.1 (~CLK), IC12.13 (~CLK), IC13.1 (~CLK), IC13.13 (~CLK), IC14.1 (~CLK), IC14.13 (~CLK)
/VGA_signals_timing_generator/40Mhz_VGA_clock: IC1.2 (Q1), IC8.2 (B)
/VGA_signals_timing_generator/H_CNTR_{3}: IC3.5 (Q_{3}), IC10.12 (C), IC10.13 (D), IC15.2 (B)
/VGA_signals_timing_generator/H_CNTR_{5}: IC3.2 (Q_{5}), IC10.2 (B), IC16.4 (C)
/VGA_signals_timing_generator/H_CNTR_{6}: IC3.4 (Q_{6}), IC15.4 (C)
/VGA_signals_timing_generator/H_CNTR_{7}: IC3.13 (Q_{7}), IC15.5 (D)
/VGA_signals_timing_generator/H_CNTR_{8}: IC3.12 (Q_{8}), IC10.4 (C)
/VGA_signals_timing_generator/H_CNTR_{9}: IC3.14 (Q_{9}), IC10.5 (D)
/VGA_signals_timing_generator/H_CNTR_{10}: IC3.15 (Q_{10}), IC16.5 (D)
/VGA_signals_timing_generator/H_FrontPorch: IC17.6 (&), TP7.1
/VGA_signals_timing_generator/H_SyncPulse: IC17.8 (&), TP6.1
/VGA_signals_timing_generator/H_backPorch: IC16.8 (&), TP5.1
/VGA_signals_timing_generator/H_reset: IC3.11 (CLR), IC4.10 (~CLK), IC11.2 (K), IC11.12 (K), IC12.2 (K), IC12.9 (Q), IC12.12 (K)
/VGA_signals_timing_generator/H_visible: IC8.4 (C), IC8.12 (C), IC11.6 (~Q), TP8.1
/VGA_signals_timing_generator/V_CNTR_{0}: IC4.9 (Q_{0}), IC18.5 (D), IC19.4 (C)
/VGA_signals_timing_generator/V_CNTR_{2}: IC4.6 (Q_{2}), IC19.5 (D), IC20.2 (B)
/VGA_signals_timing_generator/V_CNTR_{3}: IC4.5 (Q_{3}), IC9.9 (A)
/VGA_signals_timing_generator/V_CNTR_{4}: IC4.3 (Q_{4}), IC9.10 (B), IC20.4 (C)
/VGA_signals_timing_generator/V_CNTR_{5}: IC4.2 (Q_{5}), IC20.5 (D)
/VGA_signals_timing_generator/V_CNTR_{6}: IC4.4 (Q_{6}), IC9.12 (C)
/VGA_signals_timing_generator/V_CNTR_{9}: IC4.14 (Q_{9}), IC9.13 (D)
/VGA_signals_timing_generator/V_FrontPorch: IC18.8 (&), TP2.1
/VGA_signals_timing_generator/V_backPorch: IC7.11 (CLR), IC20.8 (&), TP4.1
/VGA_signals_timing_generator/V_reset: IC4.11 (CLR), IC13.2 (K), IC13.12 (K), IC14.2 (K), IC14.9 (Q), IC14.12 (K)
/VGA_signals_timing_generator/V_visible: IC8.5 (D), IC8.13 (D), IC13.6 (~Q), TP1.1
/VGA_signals_timing_generator/firstCounterOverflow: IC6.1 (Q_{11}), IC6.11 (CLR), IC8.10 (B)
/VGA_signals_timing_generator/~RESET: IC11.14 (~CLR), IC11.15 (~CLR), IC12.14 (~CLR), IC12.15 (~CLR), IC13.14 (~CLR), IC13.15 (~CLR), IC14.14 (~CLR), IC14.15 (~CLR), IC21.4 (~PRESET)
/Video_bus/Bank_0_~WE: IC22.24 (A_{2}_8), IC24#2.24 (A_{2}_8), U6.15 (~WE), U8.15 (~WE), U10.15 (~WE)
/Video_bus/Bank_1_~WE: IC28#2.24 (A_{2}_8), IC29#2.24 (A_{2}_8), U7.15 (~WE), U9.15 (~WE), U11.15 (~WE)
/Video_bus/F~B: IC5#2.55 (2~OE), IC5#2.56 (1~OE), IC21.5 (Q), IC24#2.55 (2~OE), IC24#2.56 (1~OE), IC26.55 (2~OE), IC26.56 (1~OE), IC29#2.55 (2~OE), IC29#2.56 (1~OE)
/Video_bus/MCU_pixelData.D_{0}: IC5#2.54 (B_{1}_1), IC25#2.54 (B_{1}_1)
/Video_bus/MCU_pixelData.D_{1}: IC5#2.53 (B_{1}_2), IC25#2.53 (B_{1}_2)
/Video_bus/MCU_pixelData.D_{2}: IC5#2.52 (B_{1}_3), IC25#2.52 (B_{1}_3)
/Video_bus/MCU_pixelData.D_{3}: IC5#2.51 (B_{1}_4), IC25#2.51 (B_{1}_4)
/Video_bus/MCU_pixelData.D_{4}: IC5#2.50 (B_{1}_5), IC25#2.50 (B_{1}_5)
/Video_bus/MCU_pixelData.D_{5}: IC5#2.48 (B_{1}_6), IC25#2.48 (B_{1}_6)
/Video_bus/MCU_pixelData.D_{6}: IC5#2.47 (B_{1}_7), IC25#2.47 (B_{1}_7)
/Video_bus/MCU_pixelData.D_{7}: IC5#2.46 (B_{1}_8), IC25#2.46 (B_{1}_8)
/Video_bus/MCU_pixelData.D_{8}: IC5#2.45 (B_{1}_9), IC25#2.45 (B_{1}_9)
/Video_bus/MCU_pixelData.D_{9}: IC5#2.44 (B_{1}_10), IC25#2.44 (B_{1}_10)
/Video_bus/MCU_pixelData.D_{10}: IC5#2.43 (B_{1}_11), IC25#2.43 (B_{1}_11)
/Video_bus/MCU_pixelData.D_{11}: IC5#2.42 (B_{1}_12), IC25#2.42 (B_{1}_12)
/Video_bus/MCU_pixelData.D_{12}: IC5#2.41 (B_{2}_1), IC25#2.41 (B_{2}_1)
/Video_bus/MCU_pixelData.D_{13}: IC5#2.40 (B_{2}_2), IC25#2.40 (B_{2}_2)
/Video_bus/MCU_pixelData.D_{14}: IC5#2.39 (B_{2}_3), IC25#2.39 (B_{2}_3)
/Video_bus/MCU_pixelData.D_{15}: IC5#2.37 (B_{2}_4), IC25#2.37 (B_{2}_4)
/Video_bus/MCU_pixelData.D_{16}: IC5#2.36 (B_{2}_5), IC25#2.36 (B_{2}_5)
/Video_bus/MCU_pixelData.D_{17}: IC5#2.35 (B_{2}_6), IC25#2.35 (B_{2}_6)
/Video_bus/MCU_pixelData.D_{18}: IC5#2.34 (B_{2}_7), IC25#2.34 (B_{2}_7)
/Video_bus/MCU_pixelData.D_{19}: IC5#2.33 (B_{2}_8), IC25#2.33 (B_{2}_8)
/Video_bus/MCU_pixelData.D_{20}: IC5#2.32 (B_{2}_9), IC25#2.32 (B_{2}_9)
/Video_bus/MCU_pixelData.D_{21}: IC5#2.31 (B_{2}_10), IC25#2.31 (B_{2}_10)
/Video_bus/MCU_pixelData.D_{22}: IC5#2.30 (B_{2}_11), IC25#2.30 (B_{2}_11)
/Video_bus/MCU_pixelData.D_{23}: IC5#2.29 (B_{2}_12), IC25#2.29 (B_{2}_12)
GND: C1.1, C4.1, C5.2, C6.2, C7.2, C12.2, C13.2, C14.2, C15.2, C16.2, C17.2, C18.2, C19.2, C20.2, C21.2, C22.2, C23.2, C24.2, C25.2, C26.2, IC1.6 (GND), IC2.8 (GND_1), IC2.19 (GND_2), IC2.38 (GND_3), IC2.49 (GND_4), IC3.8 (GND), IC4.8 (GND), IC5.8 (GND_1), IC5.19 (GND_2), IC5.25 (A_{2}_9), IC5.26 (A_{2}_10), IC5.27 (A_{2}_11), IC5.28 (A_{2}_12), IC5.29 (B_{2}_12), IC5.30 (B_{2}_11), IC5.31 (B_{2}_10), IC5.32 (B_{2}_9), IC5.38 (GND_3), IC5.49 (GND_4), IC5#2.8 (GND_1), IC5#2.19 (GND_2), IC5#2.38 (GND_3), IC5#2.49 (GND_4), IC6.8 (GND), IC7.8 (GND), IC8.7 (GND), IC9.7 (GND), IC10.7 (GND), IC11.8 (GND), IC12.8 (GND), IC13.8 (GND), IC14.8 (GND), IC15.7 (GND), IC16.7 (GND), IC17.7 (GND), IC18.7 (GND), IC19.7 (GND), IC20.7 (GND), IC21.8 (GND), IC21.11 (J), IC21.12 (K), IC21.13 (~CLK), IC21.15 (~CLR), IC22.8 (GND_1), IC22.19 (GND_2), IC22.29 (B_{2}_12), IC22.30 (B_{2}_11), IC22.31 (B_{2}_10), IC22.32 (B_{2}_9), IC22.38 (GND_3), IC22.49 (GND_4), IC22#2.8 (GND_1), IC22#2.19 (GND_2), IC22#2.38 (GND_3), IC22#2.49 (GND_4), IC23.7 (GND), IC24.8 (GND_1), IC24.19 (GND_2), IC24.25 (A_{2}_9), IC24.26 (A_{2}_10), IC24.27 (A_{2}_11), IC24.28 (A_{2}_12), IC24.29 (B_{2}_12), IC24.30 (B_{2}_11), IC24.31 (B_{2}_10), IC24.32 (B_{2}_9), IC24.38 (GND_3), IC24.49 (GND_4), IC24#2.8 (GND_1), IC24#2.19 (GND_2), IC24#2.29 (B_{2}_12), IC24#2.30 (B_{2}_11), IC24#2.31 (B_{2}_10), IC24#2.32 (B_{2}_9), IC24#2.38 (GND_3), IC24#2.49 (GND_4), IC25.8 (GND_1), IC25.19 (GND_2), IC25.38 (GND_3), IC25.49 (GND_4), IC25#2.8 (GND_1), IC25#2.19 (GND_2), IC25#2.38 (GND_3), IC25#2.49 (GND_4), IC26.8 (GND_1), IC26.19 (GND_2), IC26#2.8 (GND_1), IC26#2.19 (GND_2), IC26#2.25 (A_{2}_9), IC26#2.26 (A_{2}_10), IC26#2.27 (A_{2}_11), IC26#2.28 (A_{2}_12), IC26#2.29 (B_{2}_12), IC26#2.30 (B_{2}_11), IC26#2.31 (B_{2}_10), IC26#2.32 (B_{2}_9), IC26#2.38 (GND_3), IC26#2.49 (GND_4), IC27.2 (Dir_(AB|~BA)), IC27.11 (GND), IC27.12 (GND), IC27.13 (GND), IC27.22 (~OE), IC28.8 (GND_1), IC28.19 (GND_2), IC28.38 (GND_3), IC28.49 (GND_4), IC28#2.8 (GND_1), IC28#2.19 (GND_2), IC28#2.29 (B_{2}_12), IC28#2.30 (B_{2}_11), IC28#2.31 (B_{2}_10), IC28#2.32 (B_{2}_9), IC28#2.38 (GND_3), IC28#2.49 (GND_4), IC29.8 (GND_1), IC29.19 (GND_2), IC29.25 (A_{2}_9), IC29.26 (A_{2}_10), IC29.27 (A_{2}_11), IC29.28 (A_{2}_12), IC29.29 (B_{2}_12), IC29.30 (B_{2}_11), IC29.31 (B_{2}_10), IC29.32 (B_{2}_9), IC29.38 (GND_3), IC29.49 (GND_4), IC29#2.8 (GND_1), IC29#2.19 (GND_2), IC29#2.29 (B_{2}_12), IC29#2.30 (B_{2}_11), IC29#2.31 (B_{2}_10), IC29#2.32 (B_{2}_9), IC29#2.38 (GND_3), IC29#2.49 (GND_4), IC30.9 (BCB1), IC30.10 (BCB0), IC30.21 (RCR8), IC30.22 (RCR9), IC30.27 (GY9), IC30.28 (GY8), J1.1, U6.8 (~CE), U6.12 (GND), U6.34 (GND), U6.37 (~OE), U7.8 (~CE), U7.12 (GND), U7.34 (GND), U7.37 (~OE), U8.8 (~CE), U8.12 (GND), U8.34 (GND), U8.37 (~OE), U9.8 (~CE), U9.12 (GND), U9.34 (GND), U9.37 (~OE), U10.8 (~CE), U10.12 (GND), U10.34 (GND), U10.37 (~OE), U11.8 (~CE), U11.12 (GND), U11.34 (GND), U11.37 (~OE)
unnamed: C2.1, C3.1, U1.71 (VCAP), U1.106 (VCAP)
unnamed: C2.2, C3.2
unnamed: IC6.10 (~CLK), IC8.6 (&)
unnamed: IC7.10 (~CLK), IC8.8 (&)
unnamed: IC10.6 (&), IC11.3 (J)
unnamed: IC10.8 (&), IC11.11 (J)
unnamed: IC10.10 (B), IC11.5 (Q), IC17.4 (C)
unnamed: IC11.9 (Q), IC15.1 (A), IC17.12 (C)
unnamed: IC11.7 (~Q), IC17.5 (D)
unnamed: IC12.3 (J), IC15.6 (&)
unnamed: IC12.5 (Q), IC16.2 (B), IC16.12 (C)
unnamed: IC12.6 (~Q), IC17.13 (D)
unnamed: IC12.11 (J), IC16.6 (&)
unnamed: IC12.7 (~Q), IC16.13 (D)
unnamed: IC9.8 (&), IC13.3 (J)
unnamed: IC13.5 (Q), IC18.4 (C), IC18.12 (C)
unnamed: IC13.11 (J), IC18.6 (&)
unnamed: IC13.9 (Q), IC19.2 (B), IC19.12 (C)
unnamed: IC13.7 (~Q), IC18.13 (D)
unnamed: IC14.3 (J), IC19.6 (&)
unnamed: IC14.5 (Q), IC20.1 (A), IC20.12 (C)
unnamed: IC14.6 (~Q), IC19.13 (D)
unnamed: IC14.11 (J), IC20.6 (&)
unnamed: IC14.7 (~Q), IC20.13 (D)
unnamed: IC21.1 (~CLK), IC23.6 (&)
unnamed: IC22#2.56 (1~OE), IC24.56 (1~OE)
unnamed: IC22#2.55 (2~OE), IC24.55 (2~OE)
unnamed: IC25.56 (1~OE), IC26#2.56 (1~OE)
unnamed: IC25.55 (2~OE), IC26#2.55 (2~OE)
unnamed: IC26.38 (GND_3), IC26.49 (GND_4)
unnamed: IC28.56 (1~OE), IC29.56 (1~OE)
unnamed: IC28.55 (2~OE), IC29.55 (2~OE)
unnamed: U1.16 (VSS), U1.38 (VSS), U1.51 (VSS), U1.61 (VSS), U1.83 (VSS), U1.94 (VSS), U1.107 (VSS), U1.120 (VSS), U1.130 (VSS)
unnamed: U2.23 (VSS), U2.35 (VSS), U2.47 (VSS)
unnamed: U3.A1 (VSS), U3.A19 (VSS), U3.B2 (VSS), U3.B6 (VSS), U3.C3 (VSS), U3.C12 (VSS), U3.C13 (VSS), U3.C14 (VSS), U3.C15 (VSS), U3.C16 (VSS), U3.C17 (VSS), U3.D1 (VSS), U3.D4 (VSS), U3.D5 (VSS), U3.D8 (VSS), U3.E2 (VSS), U3.E4 (VSS), U3.E5 (VSS), U3.E6 (VSS), U3.E8 (VSS), U3.E10 (VSS), U3.E12 (VSS), U3.E14 (VSS), U3.E16 (VSS), U3.F5 (VSS), U3.F7 (VSS), U3.F9 (VSS), U3.F11 (VSS), U3.F15 (VSS), U3.G2 (VSS), U3.G4 (VSS), U3.G6 (VSS), U3.G8 (VSS), U3.G10 (VSS), U3.G12 (VSS), U3.G14 (VSS), U3.H5 (VSS), U3.H7 (VSS), U3.H9 (VSS), U3.H11 (VSS), U3.H13 (VSS), U3.H15 (VSS), U3.J3 (VSS), U3.J6 (VSS), U3.J8 (VSS), U3.J10 (VSS), U3.J12 (VSS), U3.J14 (VSS), U3.K2 (VSS), U3.K5 (VSS), U3.K7 (VSS), U3.K9 (VSS), U3.K11 (VSS), U3.K13 (VSS), U3.K15 (VSS), U3.L6 (VSS), U3.L8 (VSS), U3.L10 (VSS), U3.L12 (VSS), U3.L14 (VSS), U3.M5 (VSS), U3.M7 (VSS), U3.M9 (VSS), U3.M11 (VSS), U3.M13 (VSS), U3.M15 (VSS), U3.N6 (VSS), U3.N8 (VSS), U3.N10 (VSS), U3.N12 (VSS), U3.N14 (VSS), U3.P7 (VSS), U3.P9 (VSS), U3.P11 (VSS), U3.P13 (VSS), U3.P15 (VSS), U3.R2 (VSS), U3.R6 (VSS), U3.R8 (VSS), U3.R10 (VSS), U3.R12 (VSS), U3.R14 (VSS), U3.R16 (VSS), U3.T4 (VSS), U3.U3 (VSS), U3.U6 (VSS), U3.U8 (VSS), U3.U17 (VSS), U3.W1 (VSS), U3.W19 (VSS)
unnamed: U3.N4 (VSSA), U3.P5 (VSSA), U3.R5 (VSSA)
unnamed: U3.U13 (VSS_USBHS), U3.U14 (VSS_USBHS), U3.V12 (VSS_USBHS), U3.V15 (VSS_USBHS)
VCC_AUX_3V3: C1.2, J1.8
VCC_VGA_3V3: IC6.16 (VCC), IC7.16 (VCC)
VCC_VGA_5V: C4.2, C5.1, C6.1, C7.1, C12.1, C13.1, C14.1, C15.1, C16.1, C17.1, C18.1, C19.1, C20.1, C21.1, C22.1, C23.1, C24.1, C25.1, C26.1, IC1.7 (VDD), IC1.8 (OE), IC2.17 (VCC), IC3.16 (VCC), IC4.16 (VCC), IC5.17 (VCC), IC5#2.17 (VCC), IC8.1 (A), IC8.9 (A), IC8.14 (VCC), IC9.14 (VCC), IC10.1 (A), IC10.9 (A), IC10.14 (VCC), IC11.4 (~PRESET), IC11.10 (~PRESET), IC11.16 (VCC), IC12.4 (~PRESET), IC12.10 (~PRESET), IC12.16 (VCC), IC13.4 (~PRESET), IC13.10 (~PRESET), IC13.16 (VCC), IC14.4 (~PRESET), IC14.10 (~PRESET), IC14.16 (VCC), IC15.14 (VCC), IC16.1 (A), IC16.9 (A), IC16.10 (B), IC16.14 (VCC), IC17.1 (A), IC17.2 (B), IC17.9 (A), IC17.10 (B), IC17.14 (VCC), IC18.1 (A), IC18.2 (B), IC18.9 (A), IC18.10 (B), IC18.14 (VCC), IC19.1 (A), IC19.9 (A), IC19.10 (B), IC19.14 (VCC), IC20.9 (A), IC20.10 (B), IC20.14 (VCC), IC21.2 (K), IC21.3 (J), IC21.10 (~PRESET), IC21.14 (~CLR), IC21.16 (VCC), IC22.17 (VCC), IC22.33 (B_{2}_8), IC22#2.17 (VCC), IC23.14 (VCC), IC24.17 (VCC), IC24#2.17 (VCC), IC25.17 (VCC), IC25#2.17 (VCC), IC26.17 (VCC), IC26#2.17 (VCC), IC27.1 (VCCA), IC28.17 (VCC), IC28#2.17 (VCC), IC29.17 (VCC), IC29#2.17 (VCC), IC29#2.33 (B_{2}_8), U6.11 (VDD), U6.33 (VDD), U7.11 (VDD), U7.33 (VDD), U8.11 (VDD), U8.33 (VDD), U9.11 (VDD), U9.33 (VDD), U10.11 (VDD), U10.33 (VDD), U11.11 (VDD), U11.33 (VDD)
~FrontBufferBackBuffer: IC2.55 (2~OE), IC2.56 (1~OE), IC21.6 (~Q), IC22.55 (2~OE), IC22.56 (1~OE), IC25#2.55 (2~OE), IC25#2.56 (1~OE), IC28#2.55 (2~OE), IC28#2.56 (1~OE)
